dannyandreev/TheLittleRascal-Electrical/Prime Mover V1.6/Prime Mover V1.6 BOM/Prime Mover V1.6 BOM.ods

Id | Designator | Package | Quantity | Designation | Supplier and ref | Through
1 | JP1 | SolderJumper-2_P1.3mm_Open_RoundedPad1.0x1.5mm | 1 | Jumper_2_Bridged | N/A
2 | C7,C5 | C_0805_2012Metric | 2 | 4.7uF 16v | EMF212AB7475MGHT
3 | J7,J6,J1 | JST_PH_B6B-PH-K_1x06_P2.00mm_Vertical | 3 | Conn_01x06_Male | B6B-PH-K-S(LF)(SN) | TRUE
4 | C8,C6,C4 | CP_Elec_5x5.3 | 3 | 22uF 10v | 875105242005 | Double Check
5 | IC1 | SOP65P640X110-20N | 1 | NTS0308EPWJ | NTS0308EPWJ
6 | U2,U3 | SOIC-16_3.9x9.9mm_P1.27mm | 2 | MCP3008 | MCP3008
7 | J9,J10,J8 | JST_PH_B7B-PH-K_1x07_P2.00mm_Vertical | 3 | Conn_01x07_Male | B7B-PH-K-S(LF)(SN) | TRUE
8 | H1,H4,H3,H2 | MountingHole_3.2mm_M3_DIN965_Pad | 4 | MountingHole_Pad | N/A
9 | R8 | R_0805_2012Metric | 1 | 10k | RMCF0805JT10K0
10 | D2,D4,D3 | LED_0805_2012Metric | 3 | LED | XZMOK54W-1
11 | R6 | R_0805_2012Metric | 1 | 120k | RMCF0805JT120K
12 | L1 | INDPM7066X500N | 1 | 1uH | MWSA0624S-1R0MT
13 | J2 | JST_PH_B4B-PH-K_1x04_P2.00mm_Vertical | 1 | Conn_01x04_Male | B4B-PH-K-S(LF)(SN) | TRUE
14 | R7 | R_0805_2012Metric | 1 | 22k | ERJ-6GEYJ223V
15 | C10,C9 | C_0805_2012Metric | 2 | 1.0uF 16v | CC0805MKX7R7BB105
16 | J4 | JST_PH_B9B-PH-K_1x09_P2.00mm_Vertical | 1 | Conn_01x09_Male | B9B-PH-K-S(LF)(SN) | TRUE
17 | R10 | R_0805_2012Metric | 1 | 1k2 | RMCF0805JT1K20
18 | U1 | PCA9685 HW170 | 0 | PCA9685 | N/A
19 | R2,R1 | R_0805_2012Metric | 2 | 4k7 | RMCF0805JT4K70
20 | R4 | R_0805_2012Metric | 1 | 4.7k | RMCF0805JT4K70
21 | R9 | R_0805_2012Metric | 1 | 3k3 | RNCF0805DTE3K32
22 | J3,J5 | JST_PH_B3B-PH-K_1x03_P2.00mm_Vertical | 2 | Conn_01x03_Male | B3B-PH-K-S(LF)(SN) | TRUE
23 | IC2 | MAX20404AFOCVY | 1 | MAX20404AFOC_VY+ | MAX20405AFOD/VY+
24 | R5 | R_0805_2012Metric | 1 | 1.5k | RNCP0805FTD1K50
25 | C1 | C_0805_2012Metric | 1 | 0.1uF 16V | 0805YC104JAT4A
26 | D1 | D_SOD-323_HandSoldering | 1 | 3V6 | BZT52C3V6S-7-F
27 | C2 | C_0805_2012Metric | 1 | 0.1uF 16v | 0805YC104JAT4A
28 | C3 | C_0805_2012Metric | 1 | 2.2uF 10v | C0805X225K8RAC7800
29 | J11 | AMASS_XT60-M_1x02_P7.20mm_Vertical | 1 | Conn_01x02_Male | AMASS_XT60-M | TRUE
30 | R3 | PinSocket_2x20_P2.54mm_Vertical | 1 | Raspberry_Pi_2_3 | PPTC202LFBN-RC | TRUE
31 | J12 | MPU-6050-Module | 0 | Conn_01x08_Male | N/A
