dannyandreev/TheLittleRascal-Electrical/Prime Mover V1.6/Prime Mover.step.SLDASM

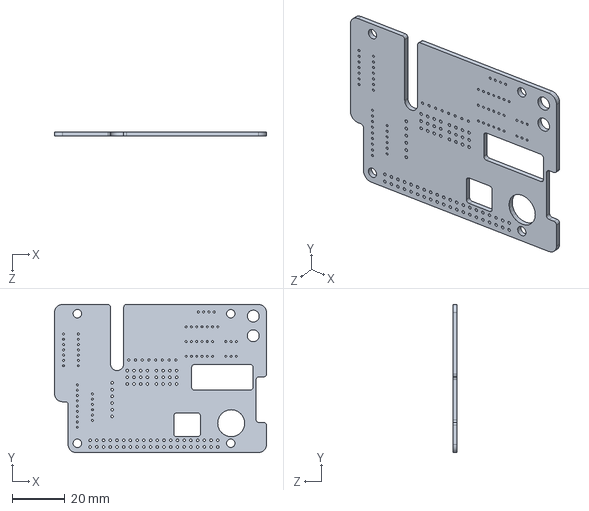
[picture p1: CAD file, 2022-08-15]
Prime Mover V1.6/Prime Mover.step.SLDASM
80.1 x 56.0 x 1.60 mm
