dannyandreev/TheLittleRascal-Electrical/(list of files, cad)

Other CAD files:
Prime Mover V1.6/Prime Mover.step
Prime Mover V1.5/Prime Mover.step
