dannyandreev/TheLittleRascal-Electrical/(threads)

Thread 1 (2021-09-09):

Schematic for RascalHat 1.0

ryanpleach, 2021-09-09:
**What is the feature and what does it do?**
We need to lay out everything that will connect to the Pi and how it will all connect. Based on this schematic, we can create the PCB layout.

**Describe the solution you'd like**
Create a library of sensors and PCBs in KiCad, figure out how they connect, and implement a schematic that describes the connections.

**Describe alternatives you've considered**
It is possible to not use a PCB, but doing this will minimize connectivity issues and the amount of wires. It will also be much easier to replace a given part. Danny was already familiar with KiCad.

Closed 2022-02-04.

Thread 12 (2022-02-04):

Mounting Holes Are wrong

dannyandreev, 2022-02-04:
mounting holes for raspi do not align, this may be caused by the 20x2 header not aligning properly

Thread 13 (2022-02-04):

Camera Cable Slit wrong

dannyandreev, 2022-02-04:
The slit for the camera is in the wrong position. To fix this position it over the camera plug
