dannyandreev/TheLittleRascal-Electrical/Prime Mover V1.6/Prime Mover.kicad_pcb

## KiCad design Prime Mover V1.6/Prime Mover.kicad_pcb (2022-11-23)

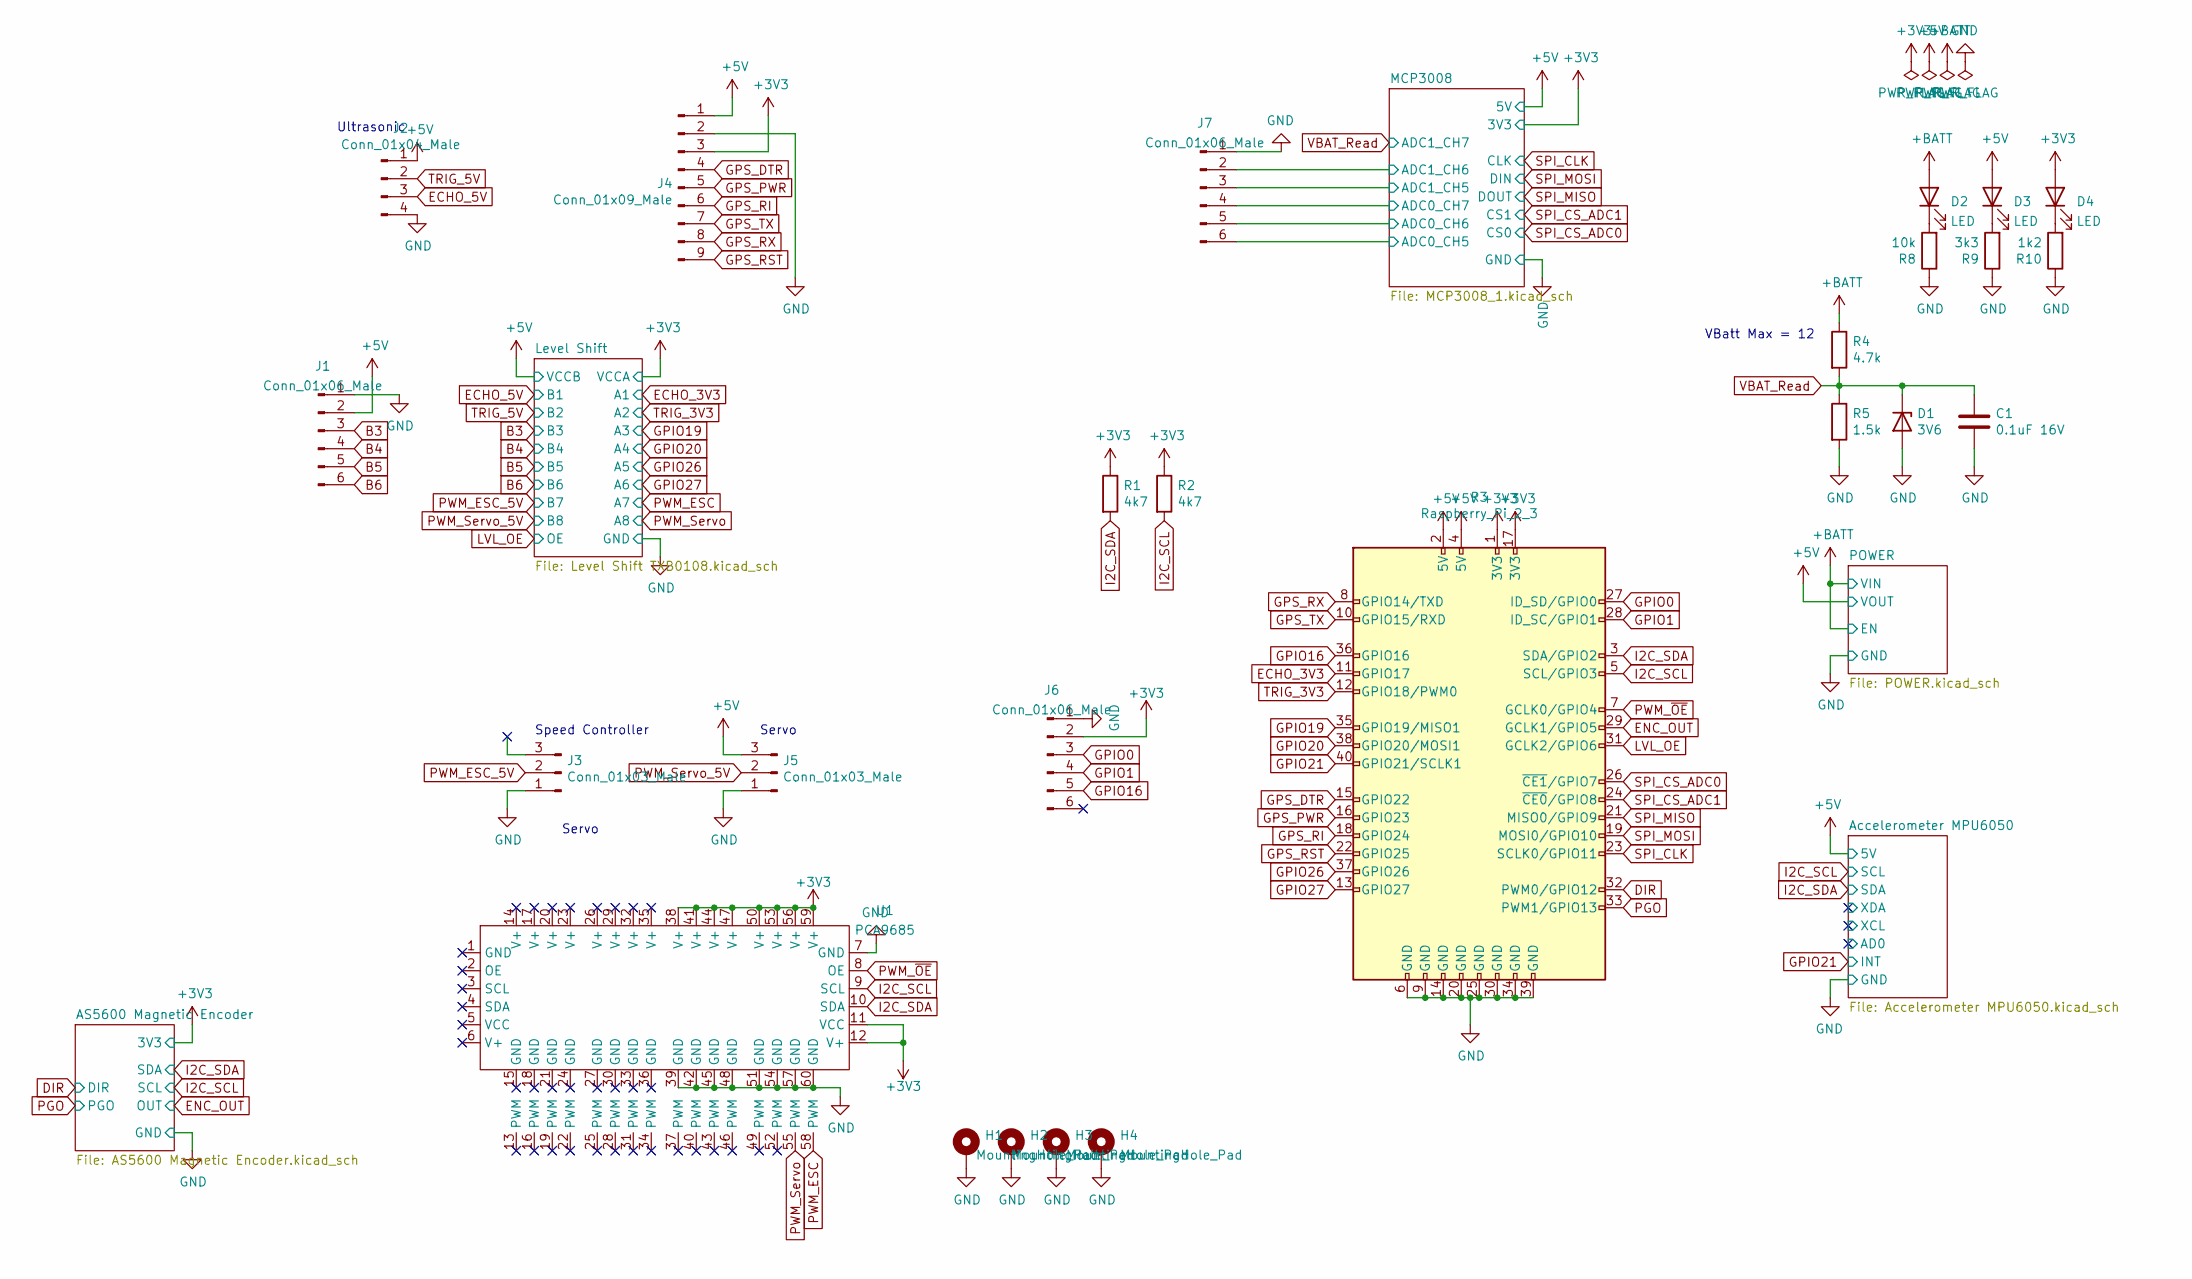
[picture p9: schematic Prime Mover.kicad_sch, RascalHat]

Parts:
C1: 0.1uF 16V; C_0805_2012Metric
D1: 3V6; D_SOD-323_HandSoldering
D2, D3, D4: LED; LED_0805_2012Metric
H1, H2, H3, H4: MountingHole_Pad; MountingHole_3.2mm_M3_DIN965_Pad
J1, J6, J7: Conn_01x06_Male; JST_PH_B6B-PH-K_1x06_P2.00mm_Vertical
J2: Conn_01x04_Male; JST_PH_B4B-PH-K_1x04_P2.00mm_Vertical
J3, J5: Conn_01x03_Male; JST_PH_B3B-PH-K_1x03_P2.00mm_Vertical
J4: Conn_01x09_Male; JST_PH_B9B-PH-K_1x09_P2.00mm_Vertical
R1, R2: 4k7; R_0805_2012Metric
R3: Raspberry_Pi_2_3; PinSocket_2x20_P2.54mm_Vertical
R4: 4.7k; R_0805_2012Metric
R5: 1.5k; R_0805_2012Metric
R8: 10k; R_0805_2012Metric
R9: 3k3; R_0805_2012Metric
R10: 1k2; R_0805_2012Metric
U1: PCA9685; PCA9685 HW170

Connections:
+3V3: D4.2 (A), J4.3, J6.2, R1.1, R2.1, R3.1 (3V3), R3.17 (3V3), U1.11 (VCC), U1.12 (V+), U1.38 (V+), U1.41 (V+), U1.44 (V+), U1.47 (V+), U1.50 (V+), U1.53 (V+), U1.56 (V+), U1.59 (V+); also elsewhere on the board
+5V: D3.2 (A), J1.2, J2.1, J4.1, J5.3, R3.2 (5V), R3.4 (5V); also elsewhere on the board
+BATT: D2.2 (A), R4.1; also elsewhere on the board
/MCP3008/ADC0_CH5: J7.6; also elsewhere on the board
/MCP3008/ADC0_CH6: J7.5; also elsewhere on the board
/MCP3008/ADC0_CH7: J7.4; also elsewhere on the board
/MCP3008/ADC1_CH5: J7.3; also elsewhere on the board
/MCP3008/ADC1_CH6: J7.2; also elsewhere on the board
B3: J1.3; also elsewhere on the board
B4: J1.4; also elsewhere on the board
B5: J1.5; also elsewhere on the board
B6: J1.6; also elsewhere on the board
DIR: R3.32 (PWM0/GPIO12); also elsewhere on the board
ECHO_3V3: R3.11 (GPIO17); also elsewhere on the board
ECHO_5V: J2.3; also elsewhere on the board
ENC_OUT: R3.29 (GCLK1/GPIO5); also elsewhere on the board
GND: C1.2, D1.2 (A), H1.1, H2.1, H3.1, H4.1, J1.1, J2.4, J3.1, J4.2, J5.1, J6.1, J7.1, R3.6 (GND), R3.9 (GND), R3.14 (GND), R3.20 (GND), R3.25 (GND), R3.30 (GND), R3.34 (GND), R3.39 (GND), R5.2, R8.1, R9.1, R10.1, U1.7 (GND), U1.39 (GND), U1.42 (GND), U1.45 (GND), U1.48 (GND), U1.51 (GND), U1.54 (GND), U1.57 (GND), U1.60 (GND); also elsewhere on the board
GPIO0: J6.3, R3.27 (ID_SD/GPIO0)
GPIO1: J6.4, R3.28 (ID_SC/GPIO1)
GPIO16: J6.5, R3.36 (GPIO16)
GPIO19: R3.35 (GPIO19/MISO1); also elsewhere on the board
GPIO20: R3.38 (GPIO20/MOSI1); also elsewhere on the board
GPIO21: R3.40 (GPIO21/SCLK1); also elsewhere on the board
GPIO26: R3.37 (GPIO26); also elsewhere on the board
GPIO27: R3.13 (GPIO27); also elsewhere on the board
GPS_DTR: J4.4, R3.15 (GPIO22)
GPS_PWR: J4.5, R3.16 (GPIO23)
GPS_RI: J4.6, R3.18 (GPIO24)
GPS_RST: J4.9, R3.22 (GPIO25)
GPS_RX: J4.8, R3.8 (GPIO14/TXD)
GPS_TX: J4.7, R3.10 (GPIO15/RXD)
I2C_SCL: R2.2, R3.5 (SCL/GPIO3), U1.9 (SCL); also elsewhere on the board
I2C_SDA: R1.2, R3.3 (SDA/GPIO2), U1.10 (SDA); also elsewhere on the board
LVL_OE: R3.31 (GCLK2/GPIO6); also elsewhere on the board
unnamed: D2.1 (K), R8.2
unnamed: D3.1 (K), R9.2
unnamed: D4.1 (K), R10.2
PGO: R3.33 (PWM1/GPIO13); also elsewhere on the board
PWM_ESC: U1.58 (PWM); also elsewhere on the board
PWM_ESC_5V: J3.2; also elsewhere on the board
PWM_Servo: U1.55 (PWM); also elsewhere on the board
PWM_Servo_5V: J5.2; also elsewhere on the board
PWM_~OE: R3.7 (GCLK0/GPIO4), U1.8 (OE)
SPI_CLK: R3.23 (SCLK0/GPIO11); also elsewhere on the board
SPI_CS_ADC0: R3.26 (~CE1/GPIO7); also elsewhere on the board
SPI_CS_ADC1: R3.24 (~CE0/GPIO8); also elsewhere on the board
SPI_MISO: R3.21 (MISO0/GPIO9); also elsewhere on the board
SPI_MOSI: R3.19 (MOSI0/GPIO10); also elsewhere on the board
TRIG_3V3: R3.12 (GPIO18/PWM0); also elsewhere on the board
TRIG_5V: J2.2; also elsewhere on the board
VBAT_Read: C1.1, D1.1 (K), R4.2, R5.1; also elsewhere on the board

Notes on the sheet:
Servo
VBatt Max = 12
Ultrasonic
Speed Controller

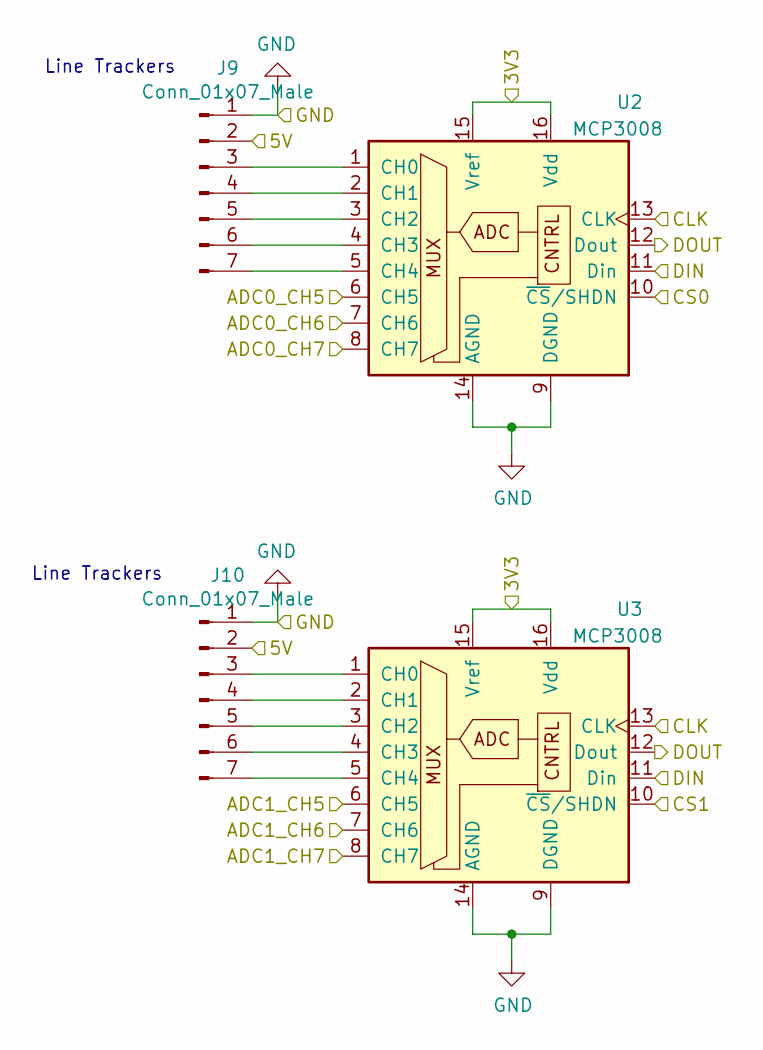
[picture p10: schematic MCP3008_1.kicad_sch]

Parts:
J9, J10: Conn_01x07_Male; JST_PH_B7B-PH-K_1x07_P2.00mm_Vertical
U2, U3: MCP3008; SOIC-16_3.9x9.9mm_P1.27mm

Connections:
+3V3: U2.15 (Vref), U2.16 (Vdd), U3.15 (Vref), U3.16 (Vdd); also elsewhere on the board
+5V: J9.2, J10.2; also elsewhere on the board
/MCP3008/ADC0_CH5: U2.6 (CH5); also elsewhere on the board
/MCP3008/ADC0_CH6: U2.7 (CH6); also elsewhere on the board
/MCP3008/ADC0_CH7: U2.8 (CH7); also elsewhere on the board
/MCP3008/ADC1_CH5: U3.6 (CH5); also elsewhere on the board
/MCP3008/ADC1_CH6: U3.7 (CH6); also elsewhere on the board
GND: J9.1, J10.1, U2.9 (DGND), U2.14 (AGND), U3.9 (DGND), U3.14 (AGND); also elsewhere on the board
unnamed: J9.3, U2.1 (CH0)
unnamed: J9.4, U2.2 (CH1)
unnamed: J9.5, U2.3 (CH2)
unnamed: J9.6, U2.4 (CH3)
unnamed: J9.7, U2.5 (CH4)
unnamed: J10.3, U3.1 (CH0)
unnamed: J10.4, U3.2 (CH1)
unnamed: J10.5, U3.3 (CH2)
unnamed: J10.6, U3.4 (CH3)
unnamed: J10.7, U3.5 (CH4)
SPI_CLK: U2.13 (CLK), U3.13 (CLK); also elsewhere on the board
SPI_CS_ADC0: U2.10 (~CS/SHDN); also elsewhere on the board
SPI_CS_ADC1: U3.10 (~CS/SHDN); also elsewhere on the board
SPI_MISO: U2.12 (Dout), U3.12 (Dout); also elsewhere on the board
SPI_MOSI: U2.11 (Din), U3.11 (Din); also elsewhere on the board
VBAT_Read: U3.8 (CH7); also elsewhere on the board

Notes on the sheet:
Line Trackers

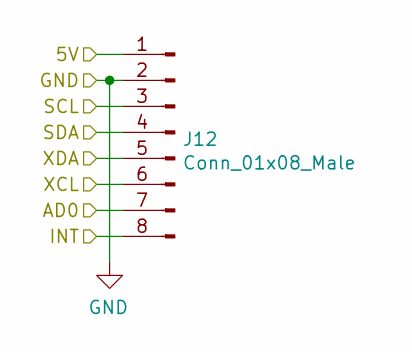
[picture p11: schematic Accelerometer MPU6050.kicad_sch]

Parts:
J12: Conn_01x08_Male; MPU-6050-Module

Connections:
+5V: J12.1; also elsewhere on the board
/Accelerometer MPU6050/AD0: J12.7
/Accelerometer MPU6050/XCL: J12.6
/Accelerometer MPU6050/XDA: J12.5
GND: J12.2; also elsewhere on the board
GPIO21: J12.8; also elsewhere on the board
I2C_SCL: J12.3; also elsewhere on the board
I2C_SDA: J12.4; also elsewhere on the board

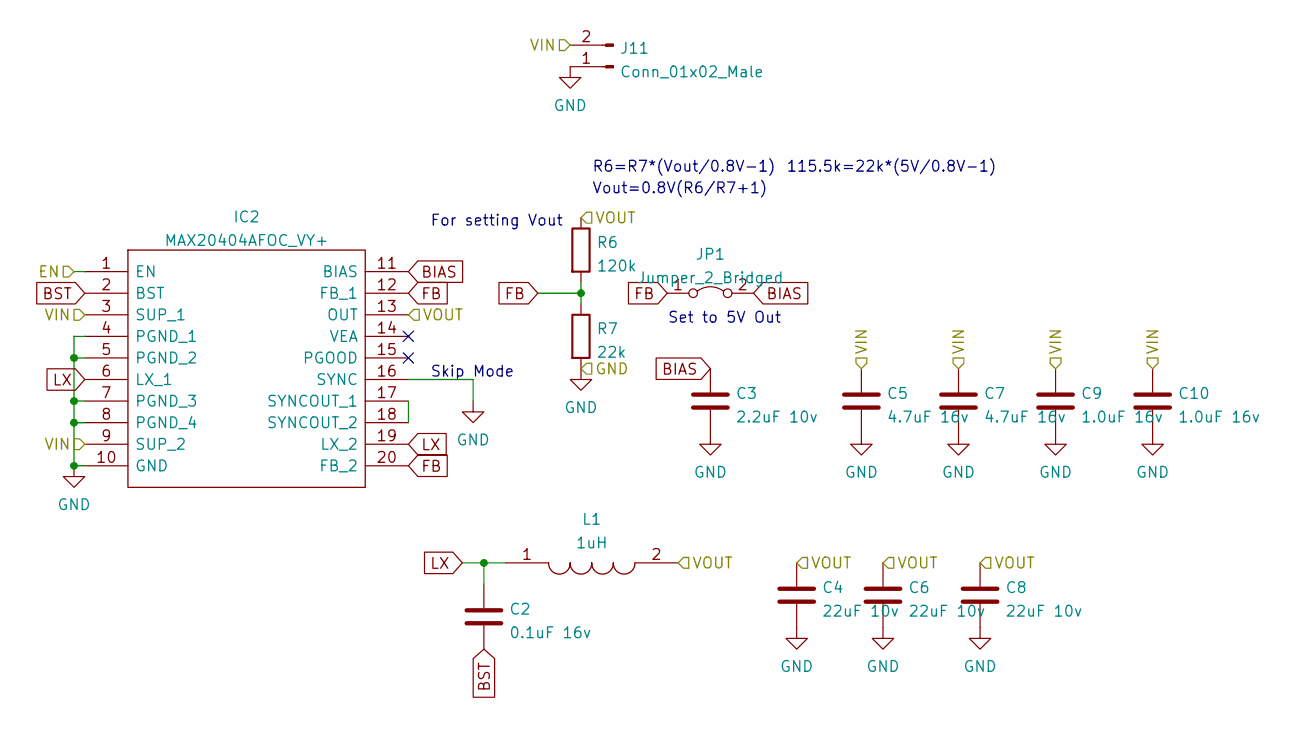
[picture p12: schematic POWER.kicad_sch]

Parts:
C2: 0.1uF 16v; C_0805_2012Metric
C3: 2.2uF 10v; C_0805_2012Metric
C4, C6, C8: 22uF 10v; CP_Elec_5x5.3
C5, C7: 4.7uF 16v; C_0805_2012Metric
C9, C10: 1.0uF 16v; C_0805_2012Metric
IC2: MAX20404AFOC_VY+; MAX20404AFOCVY; Manufacturer_Part_Number MAX20404AFOC/VY+
J11: Conn_01x02_Male; AMASS_XT60-M_1x02_P7.20mm_Vertical
JP1: Jumper_2_Bridged; SolderJumper-2_P1.3mm_Open_RoundedPad1.0x1.5mm
L1: 1uH; INDPM7066X500N; Manufacturer_Part_Number MWSA0605S-150MT
R6: 120k; R_0805_2012Metric
R7: 22k; R_0805_2012Metric

Connections:
+5V: C4.1, C6.1, C8.1, IC2.13 (OUT), L1.2, R6.1; also elsewhere on the board
+BATT: C5.1, C7.1, C9.1, C10.1, IC2.1 (EN), IC2.3 (SUP_1), IC2.9 (SUP_2), J11.2; also elsewhere on the board
BIAS: C3.1, IC2.11 (BIAS), JP1.2 (B)
BST: C2.2, IC2.2 (BST)
FB: IC2.12 (FB_1), IC2.20 (FB_2), JP1.1 (A), R6.2, R7.1
GND: C3.2, C4.2, C5.2, C6.2, C7.2, C8.2, C9.2, C10.2, IC2.4 (PGND_1), IC2.5 (PGND_2), IC2.7 (PGND_3), IC2.8 (PGND_4), IC2.10 (GND), IC2.16 (SYNC), J11.1, R7.2; also elsewhere on the board
LX: C2.1, IC2.6 (LX_1), IC2.19 (LX_2), L1.1
unnamed: IC2.17 (SYNCOUT_1), IC2.18 (SYNCOUT_2)

Notes on the sheet:
Vout=0.8V(R6/R7+1)
For setting Vout
Skip Mode
Set to 5V Out
R6=R7*(Vout/0.8V-1)
115.5k=22k*(5V/0.8V-1)

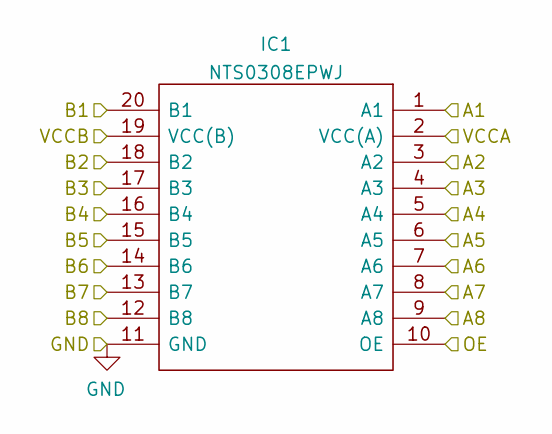
[picture p13: schematic Level Shift TXB0108.kicad_sch]

Parts:
IC1: NTS0308EPWJ; SOP65P640X110-20N; Manufacturer_Part_Number NTS0308EPWJ; Mouser Part Number 771-NTS0308EPWJ

Connections:
+3V3: IC1.2 (VCC(A)); also elsewhere on the board
+5V: IC1.19 (VCC(B)); also elsewhere on the board
B3: IC1.17 (B3); also elsewhere on the board
B4: IC1.16 (B4); also elsewhere on the board
B5: IC1.15 (B5); also elsewhere on the board
B6: IC1.14 (B6); also elsewhere on the board
ECHO_3V3: IC1.1 (A1); also elsewhere on the board
ECHO_5V: IC1.20 (B1); also elsewhere on the board
GND: IC1.11 (GND); also elsewhere on the board
GPIO19: IC1.4 (A3); also elsewhere on the board
GPIO20: IC1.5 (A4); also elsewhere on the board
GPIO26: IC1.6 (A5); also elsewhere on the board
GPIO27: IC1.7 (A6); also elsewhere on the board
LVL_OE: IC1.10 (OE); also elsewhere on the board
PWM_ESC: IC1.8 (A7); also elsewhere on the board
PWM_ESC_5V: IC1.13 (B7); also elsewhere on the board
PWM_Servo: IC1.9 (A8); also elsewhere on the board
PWM_Servo_5V: IC1.12 (B8); also elsewhere on the board
TRIG_3V3: IC1.3 (A2); also elsewhere on the board
TRIG_5V: IC1.18 (B2); also elsewhere on the board

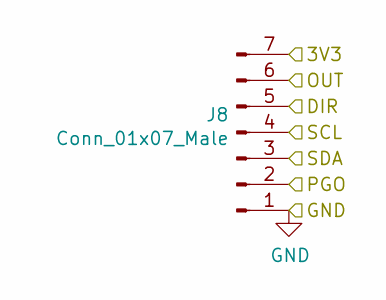
[picture p14: schematic AS5600 Magnetic Encoder.kicad_sch]

Parts:
J8: Conn_01x07_Male; JST_PH_B7B-PH-K_1x07_P2.00mm_Vertical

Connections:
+3V3: J8.7; also elsewhere on the board
DIR: J8.5; also elsewhere on the board
ENC_OUT: J8.6; also elsewhere on the board
GND: J8.1; also elsewhere on the board
I2C_SCL: J8.4; also elsewhere on the board
I2C_SDA: J8.3; also elsewhere on the board
PGO: J8.2; also elsewhere on the board

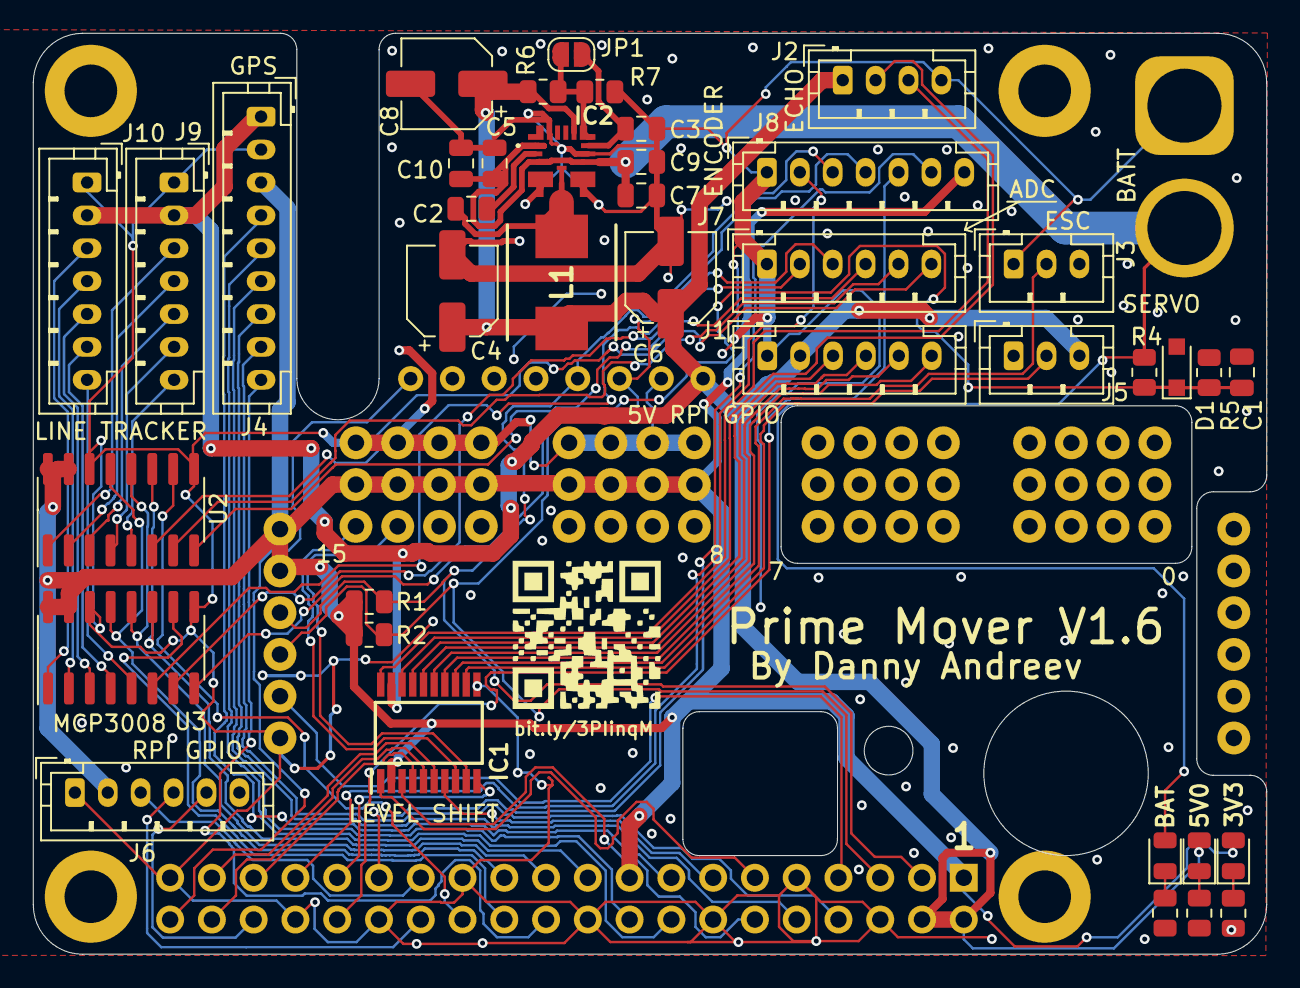
[picture p15: board Prime Mover.kicad_pcb from above]

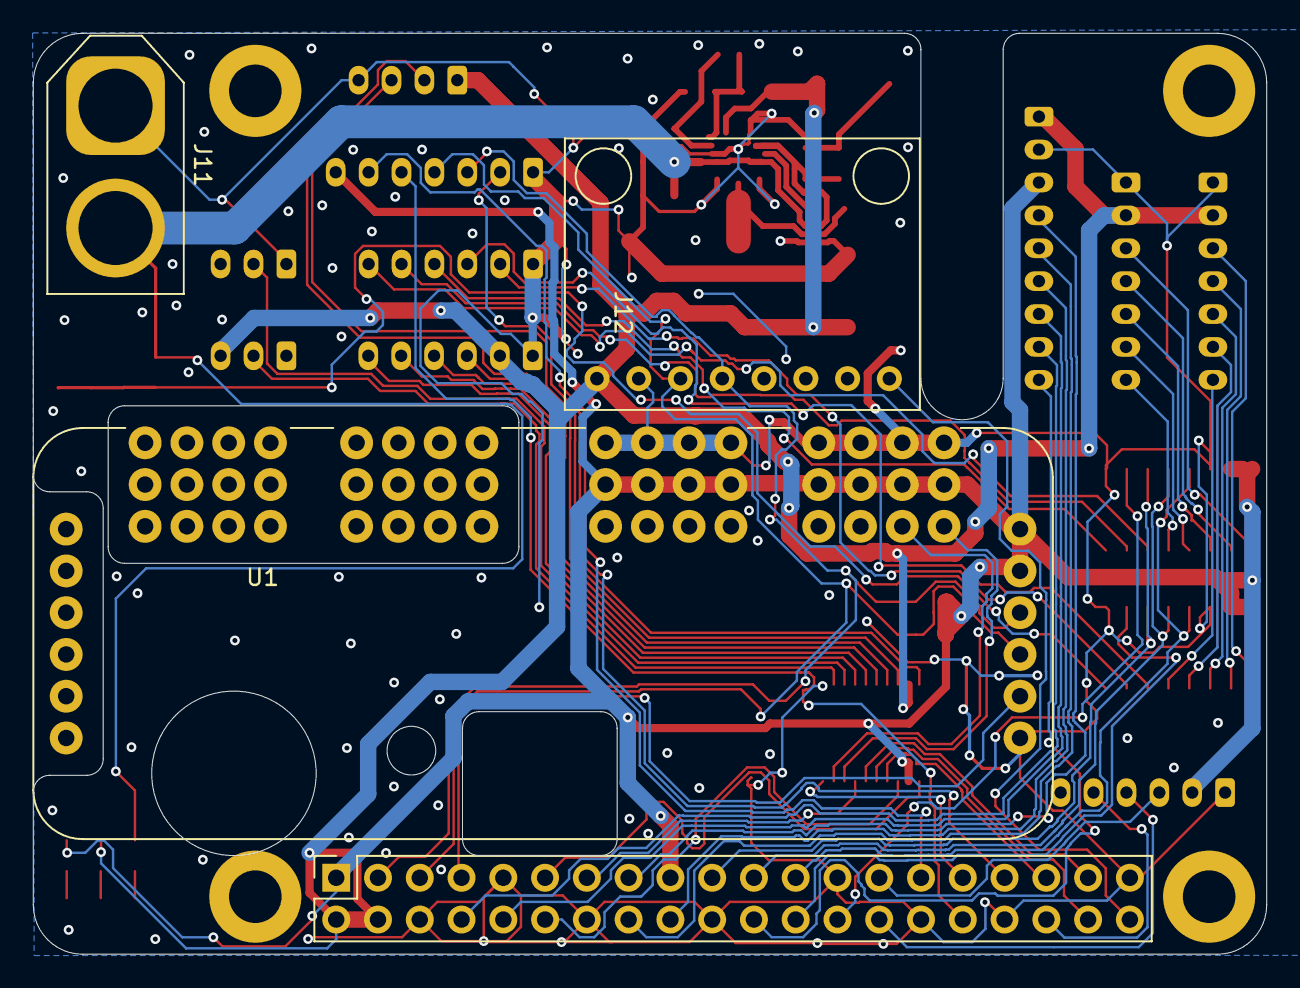
[picture p16: board Prime Mover.kicad_pcb from below]

Board: 2 copper layers, 75.0 x 56.0 mm, 47 parts (3 on the bottom side), 66 nets.
