dannyandreev/TheLittleRascal-Electrical/PiCar Hat V1.0/PiCar Hat.kicad_pcb

## KiCad design PiCar Hat V1.0/PiCar Hat.kicad_pcb (2022-02-22)

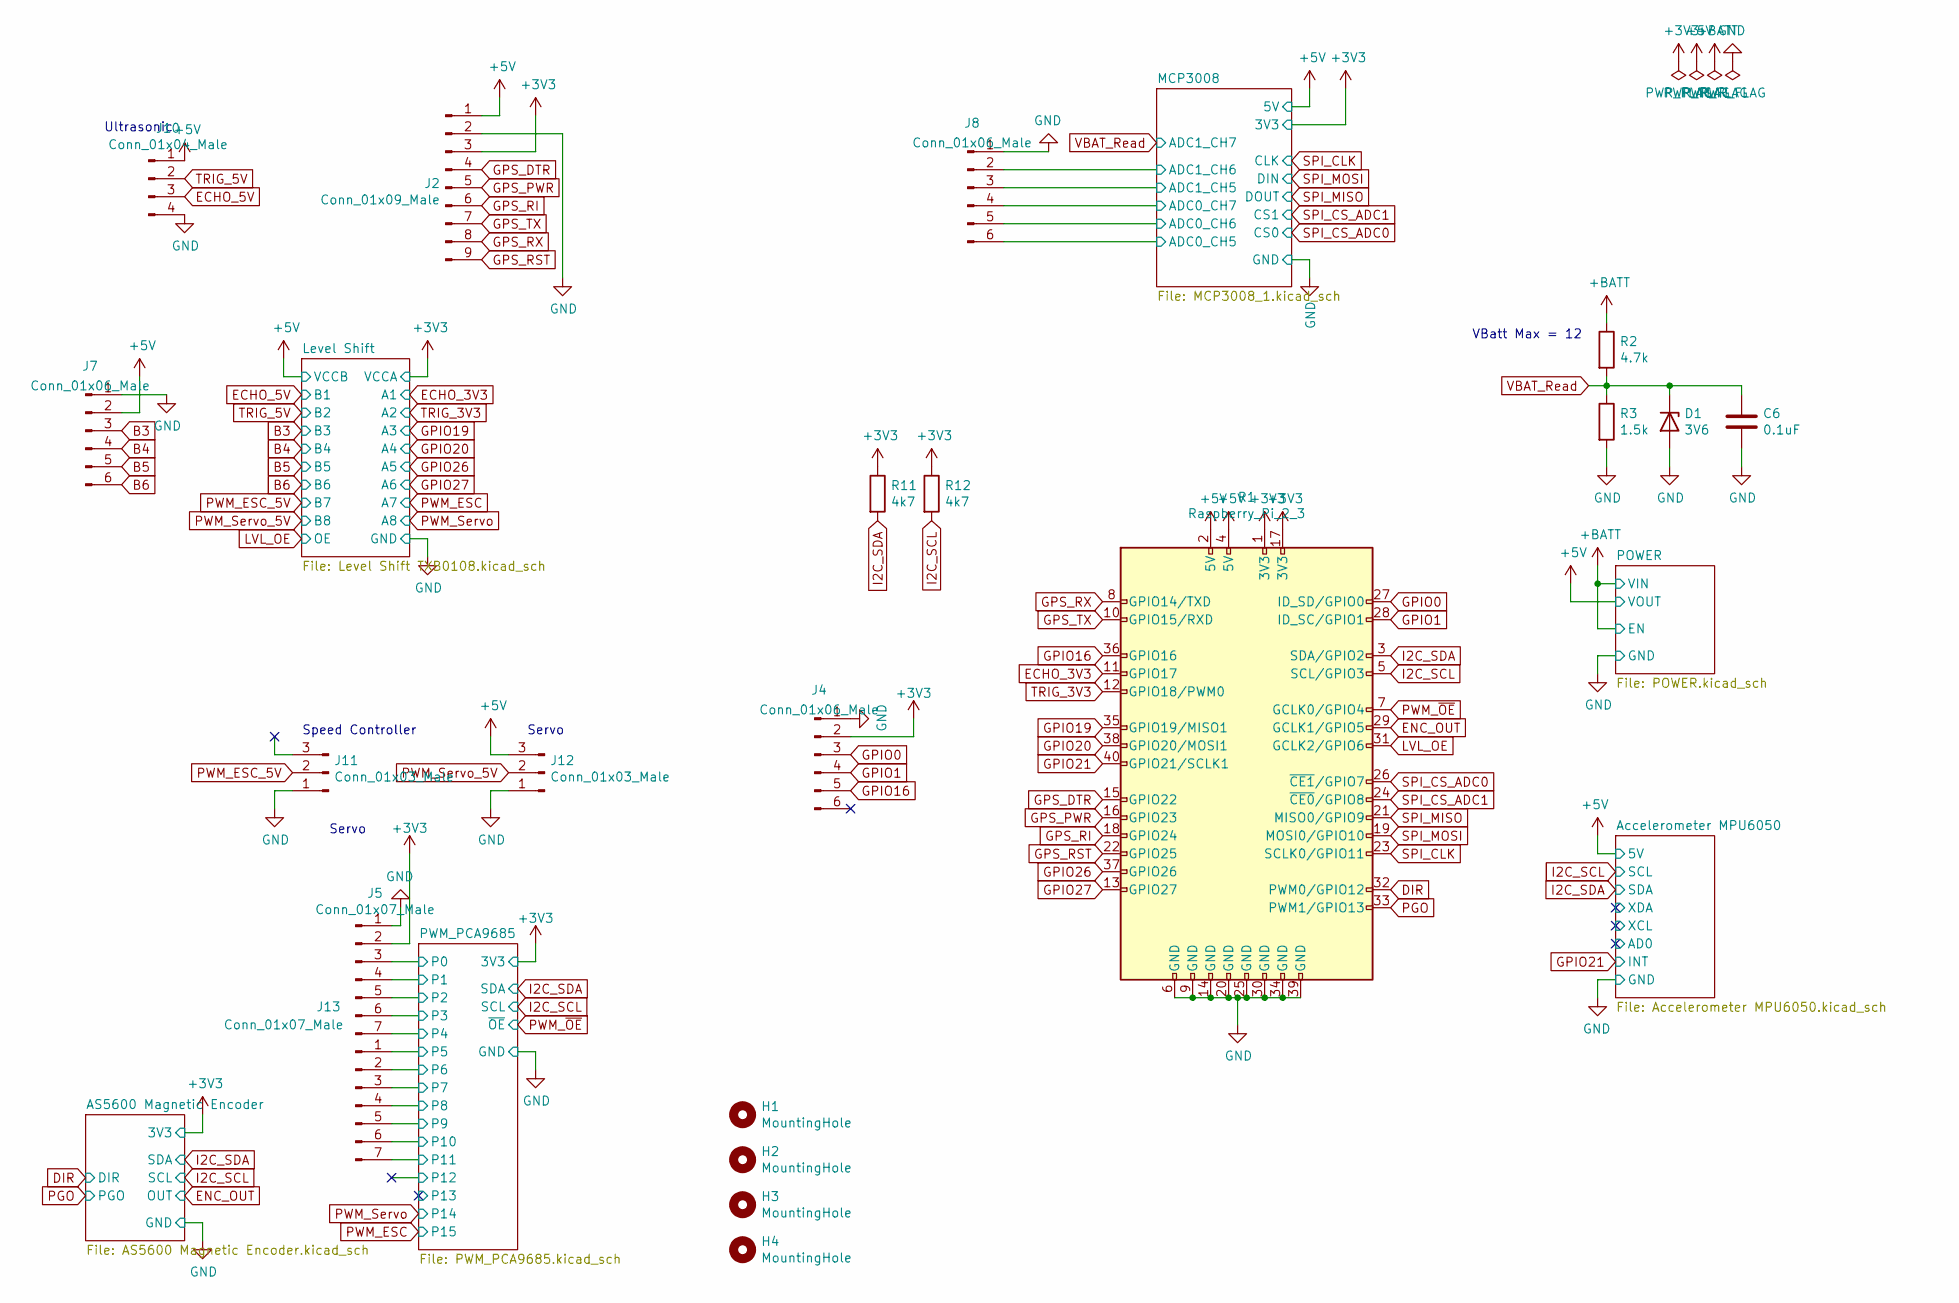
[picture p17: schematic PiCar Hat.kicad_sch, RascalHat]

Parts:
C6: 0.1uF; C_0805_2012Metric
D1: 3V6; D_SOD-323_HandSoldering
H1, H2, H3, H4: MountingHole; MountingHole_3.2mm_M3
J2: Conn_01x09_Male; JST_PH_B9B-PH-K_1x09_P2.00mm_Vertical
J4, J7, J8: Conn_01x06_Male; JST_PH_B6B-PH-K_1x06_P2.00mm_Vertical
J5, J13: Conn_01x07_Male; JST_PH_B7B-PH-K_1x07_P2.00mm_Vertical
J10: Conn_01x04_Male; JST_PH_B4B-PH-K_1x04_P2.00mm_Vertical
J11, J12: Conn_01x03_Male; JST_PH_B3B-PH-K_1x03_P2.00mm_Vertical
R1: Raspberry_Pi_2_3; PinSocket_2x20_P2.54mm_Vertical
R2: 4.7k; R_0805_2012Metric
R3: 1.5k; R_0805_2012Metric
R11, R12: 4k7; R_0805_2012Metric

Connections:
+3V3: J2.3, J4.2, J5.2, R1.1 (3V3), R1.17 (3V3), R11.1, R12.1; also elsewhere on the board
+5V: J2.1, J7.2, J10.1, J12.3, R1.2 (5V), R1.4 (5V); also elsewhere on the board
+BATT: R2.1; also elsewhere on the board
/MCP3008/ADC0_CH5: J8.6; also elsewhere on the board
/MCP3008/ADC0_CH6: J8.5; also elsewhere on the board
/MCP3008/ADC0_CH7: J8.4; also elsewhere on the board
/MCP3008/ADC1_CH5: J8.3; also elsewhere on the board
/MCP3008/ADC1_CH6: J8.2; also elsewhere on the board
/PWM_PCA9685/P0: J5.3; also elsewhere on the board
/PWM_PCA9685/P1: J5.4; also elsewhere on the board
/PWM_PCA9685/P2: J5.5; also elsewhere on the board
/PWM_PCA9685/P3: J5.6; also elsewhere on the board
/PWM_PCA9685/P4: J5.7; also elsewhere on the board
/PWM_PCA9685/P5: J13.1; also elsewhere on the board
/PWM_PCA9685/P6: J13.2; also elsewhere on the board
/PWM_PCA9685/P7: J13.3; also elsewhere on the board
/PWM_PCA9685/P8: J13.4; also elsewhere on the board
/PWM_PCA9685/P9: J13.5; also elsewhere on the board
/PWM_PCA9685/P10: J13.6; also elsewhere on the board
/PWM_PCA9685/P11: J13.7; also elsewhere on the board
B3: J7.3; also elsewhere on the board
B4: J7.4; also elsewhere on the board
B5: J7.5; also elsewhere on the board
B6: J7.6; also elsewhere on the board
DIR: R1.32 (PWM0/GPIO12); also elsewhere on the board
ECHO_3V3: R1.11 (GPIO17); also elsewhere on the board
ECHO_5V: J10.3; also elsewhere on the board
ENC_OUT: R1.29 (GCLK1/GPIO5); also elsewhere on the board
GND: C6.2, D1.2 (A), J2.2, J4.1, J5.1, J7.1, J8.1, J10.4, J11.1, J12.1, R1.6 (GND), R1.9 (GND), R1.14 (GND), R1.20 (GND), R1.25 (GND), R1.30 (GND), R1.34 (GND), R1.39 (GND), R3.2; also elsewhere on the board
GPIO0: J4.3, R1.27 (ID_SD/GPIO0)
GPIO1: J4.4, R1.28 (ID_SC/GPIO1)
GPIO16: J4.5, R1.36 (GPIO16)
GPIO19: R1.35 (GPIO19/MISO1); also elsewhere on the board
GPIO20: R1.38 (GPIO20/MOSI1); also elsewhere on the board
GPIO21: R1.40 (GPIO21/SCLK1); also elsewhere on the board
GPIO26: R1.37 (GPIO26); also elsewhere on the board
GPIO27: R1.13 (GPIO27); also elsewhere on the board
GPS_DTR: J2.4, R1.15 (GPIO22)
GPS_PWR: J2.5, R1.16 (GPIO23)
GPS_RI: J2.6, R1.18 (GPIO24)
GPS_RST: J2.9, R1.22 (GPIO25)
GPS_RX: J2.8, R1.8 (GPIO14/TXD)
GPS_TX: J2.7, R1.10 (GPIO15/RXD)
I2C_SCL: R1.5 (SCL/GPIO3), R12.2; also elsewhere on the board
I2C_SDA: R1.3 (SDA/GPIO2), R11.2; also elsewhere on the board
LVL_OE: R1.31 (GCLK2/GPIO6); also elsewhere on the board
PGO: R1.33 (PWM1/GPIO13); also elsewhere on the board
PWM_ESC_5V: J11.2; also elsewhere on the board
PWM_Servo_5V: J12.2; also elsewhere on the board
PWM_~OE: R1.7 (GCLK0/GPIO4); also elsewhere on the board
SPI_CLK: R1.23 (SCLK0/GPIO11); also elsewhere on the board
SPI_CS_ADC0: R1.26 (~CE1/GPIO7); also elsewhere on the board
SPI_CS_ADC1: R1.24 (~CE0/GPIO8); also elsewhere on the board
SPI_MISO: R1.21 (MISO0/GPIO9); also elsewhere on the board
SPI_MOSI: R1.19 (MOSI0/GPIO10); also elsewhere on the board
TRIG_3V3: R1.12 (GPIO18/PWM0); also elsewhere on the board
TRIG_5V: J10.2; also elsewhere on the board
VBAT_Read: C6.1, D1.1 (K), R2.2, R3.1; also elsewhere on the board

Notes on the sheet:
Servo
VBatt Max = 12
Ultrasonic
Speed Controller

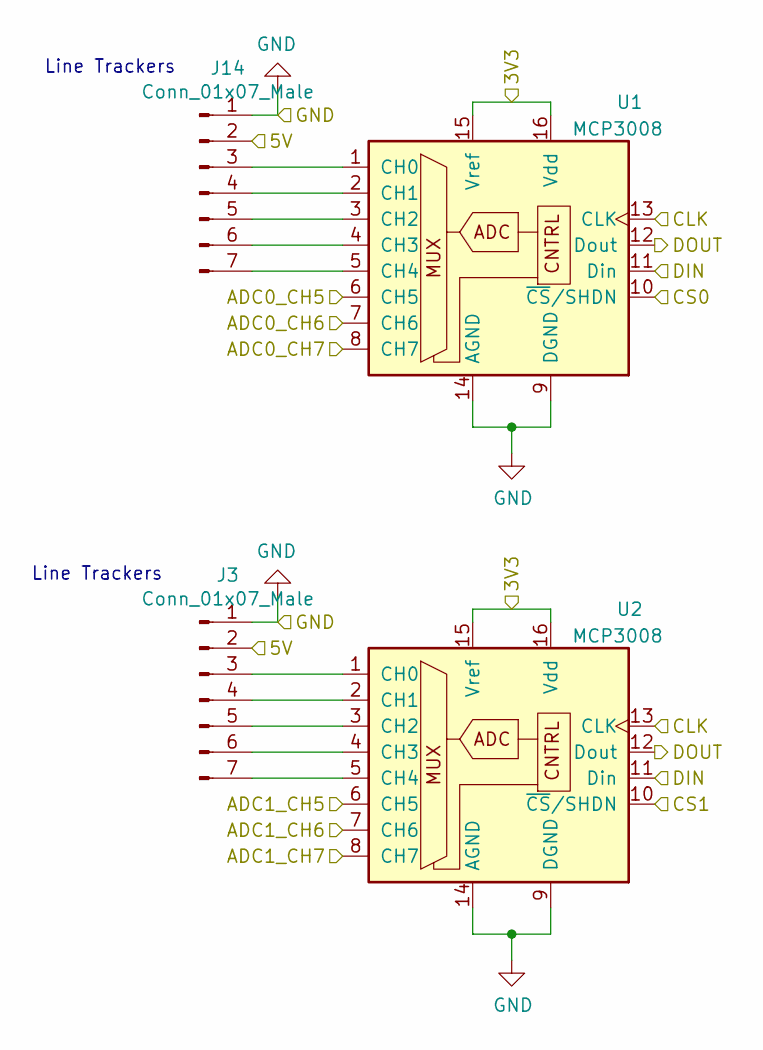
[picture p18: schematic MCP3008_1.kicad_sch]

Parts:
J3, J14: Conn_01x07_Male; JST_PH_B7B-PH-K_1x07_P2.00mm_Vertical
U1, U2: MCP3008; SOIC-16_3.9x9.9mm_P1.27mm

Connections:
+3V3: U1.15 (Vref), U1.16 (Vdd), U2.15 (Vref), U2.16 (Vdd); also elsewhere on the board
+5V: J3.2, J14.2; also elsewhere on the board
/MCP3008/ADC0_CH5: U1.6 (CH5); also elsewhere on the board
/MCP3008/ADC0_CH6: U1.7 (CH6); also elsewhere on the board
/MCP3008/ADC0_CH7: U1.8 (CH7); also elsewhere on the board
/MCP3008/ADC1_CH5: U2.6 (CH5); also elsewhere on the board
/MCP3008/ADC1_CH6: U2.7 (CH6); also elsewhere on the board
GND: J3.1, J14.1, U1.9 (DGND), U1.14 (AGND), U2.9 (DGND), U2.14 (AGND); also elsewhere on the board
unnamed: J3.3, U2.1 (CH0)
unnamed: J3.4, U2.2 (CH1)
unnamed: J3.5, U2.3 (CH2)
unnamed: J3.6, U2.4 (CH3)
unnamed: J3.7, U2.5 (CH4)
unnamed: J14.3, U1.1 (CH0)
unnamed: J14.4, U1.2 (CH1)
unnamed: J14.5, U1.3 (CH2)
unnamed: J14.6, U1.4 (CH3)
unnamed: J14.7, U1.5 (CH4)
SPI_CLK: U1.13 (CLK), U2.13 (CLK); also elsewhere on the board
SPI_CS_ADC0: U1.10 (~CS/SHDN); also elsewhere on the board
SPI_CS_ADC1: U2.10 (~CS/SHDN); also elsewhere on the board
SPI_MISO: U1.12 (Dout), U2.12 (Dout); also elsewhere on the board
SPI_MOSI: U1.11 (Din), U2.11 (Din); also elsewhere on the board
VBAT_Read: U2.8 (CH7); also elsewhere on the board

Notes on the sheet:
Line Trackers

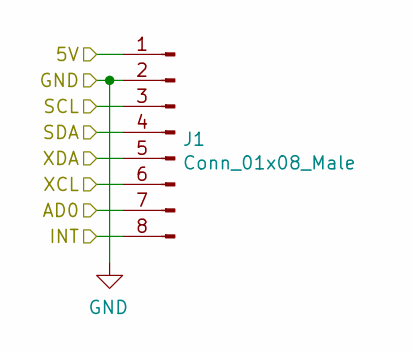
[picture p19: schematic Accelerometer MPU6050.kicad_sch]

Parts:
J1: Conn_01x08_Male; MPU-6050-Module

Connections:
+5V: J1.1; also elsewhere on the board
/Accelerometer MPU6050/AD0: J1.7
/Accelerometer MPU6050/XCL: J1.6
/Accelerometer MPU6050/XDA: J1.5
GND: J1.2; also elsewhere on the board
GPIO21: J1.8; also elsewhere on the board
I2C_SCL: J1.3; also elsewhere on the board
I2C_SDA: J1.4; also elsewhere on the board

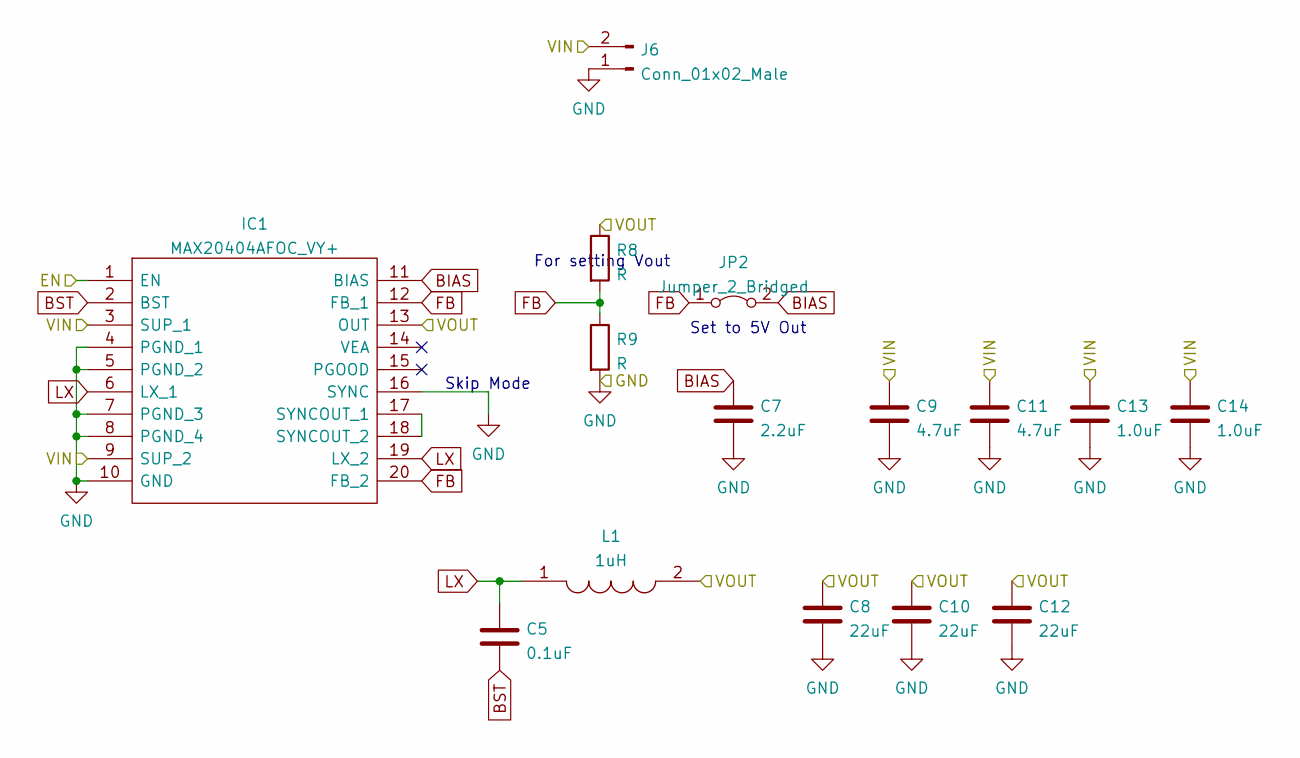
[picture p20: schematic POWER.kicad_sch]

Parts:
C5: 0.1uF; C_0805_2012Metric
C7: 2.2uF; C_0805_2012Metric
C8, C10, C12: 22uF; CP_Elec_5x5.3
C9, C11: 4.7uF; C_0805_2012Metric
C13, C14: 1.0uF; C_0805_2012Metric
IC1: MAX20404AFOC_VY+; MAX20404AFOCVY; Manufacturer_Part_Number MAX20404AFOC/VY+
J6: Conn_01x02_Male; AMASS_XT60-M_1x02_P7.20mm_Vertical
JP2: Jumper_2_Bridged; PinHeader_1x02_P2.54mm_Vertical
L1: 1uH; INDPM7066X500N; Manufacturer_Part_Number MWSA0605S-150MT
R8, R9: R; R_0805_2012Metric

Connections:
+5V: C8.1, C10.1, C12.1, IC1.13 (OUT), L1.2, R8.1; also elsewhere on the board
+BATT: C9.1, C11.1, C13.1, C14.1, IC1.1 (EN), IC1.3 (SUP_1), IC1.9 (SUP_2), J6.2; also elsewhere on the board
BIAS: C7.1, IC1.11 (BIAS), JP2.2 (B)
BST: C5.2, IC1.2 (BST)
FB: IC1.12 (FB_1), IC1.20 (FB_2), JP2.1 (A), R8.2, R9.1
GND: C7.2, C8.2, C9.2, C10.2, C11.2, C12.2, C13.2, C14.2, IC1.4 (PGND_1), IC1.5 (PGND_2), IC1.7 (PGND_3), IC1.8 (PGND_4), IC1.10 (GND), IC1.16 (SYNC), J6.1, R9.2; also elsewhere on the board
LX: C5.1, IC1.6 (LX_1), IC1.19 (LX_2), L1.1
unnamed: IC1.17 (SYNCOUT_1), IC1.18 (SYNCOUT_2)

Notes on the sheet:
For setting Vout
Skip Mode
Set to 5V Out

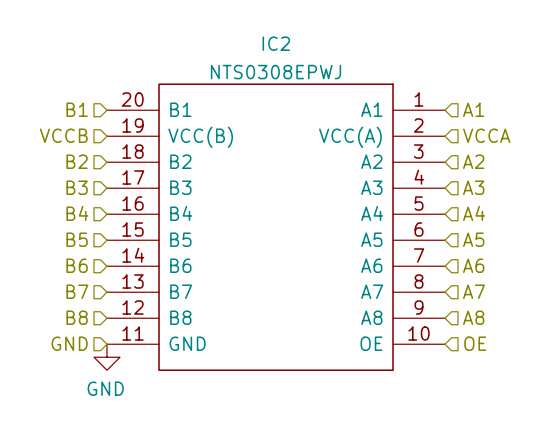
[picture p21: schematic Level Shift TXB0108.kicad_sch]

Parts:
IC2: NTS0308EPWJ; SOP65P640X110-20N; Manufacturer_Part_Number NTS0308EPWJ; Mouser Part Number 771-NTS0308EPWJ

Connections:
+3V3: IC2.2 (VCC(A)); also elsewhere on the board
+5V: IC2.19 (VCC(B)); also elsewhere on the board
B3: IC2.17 (B3); also elsewhere on the board
B4: IC2.16 (B4); also elsewhere on the board
B5: IC2.15 (B5); also elsewhere on the board
B6: IC2.14 (B6); also elsewhere on the board
ECHO_3V3: IC2.1 (A1); also elsewhere on the board
ECHO_5V: IC2.20 (B1); also elsewhere on the board
GND: IC2.11 (GND); also elsewhere on the board
GPIO19: IC2.4 (A3); also elsewhere on the board
GPIO20: IC2.5 (A4); also elsewhere on the board
GPIO26: IC2.6 (A5); also elsewhere on the board
GPIO27: IC2.7 (A6); also elsewhere on the board
LVL_OE: IC2.10 (OE); also elsewhere on the board
PWM_ESC: IC2.8 (A7); also elsewhere on the board
PWM_ESC_5V: IC2.13 (B7); also elsewhere on the board
PWM_Servo: IC2.9 (A8); also elsewhere on the board
PWM_Servo_5V: IC2.12 (B8); also elsewhere on the board
TRIG_3V3: IC2.3 (A2); also elsewhere on the board
TRIG_5V: IC2.18 (B2); also elsewhere on the board
