dannyandreev/TheLittleRascal-Electrical/PiCar Hat V1.0/PiCar Hat.kicad_pcb

## KiCad design PiCar Hat V1.0/PiCar Hat.kicad_pcb (continued)

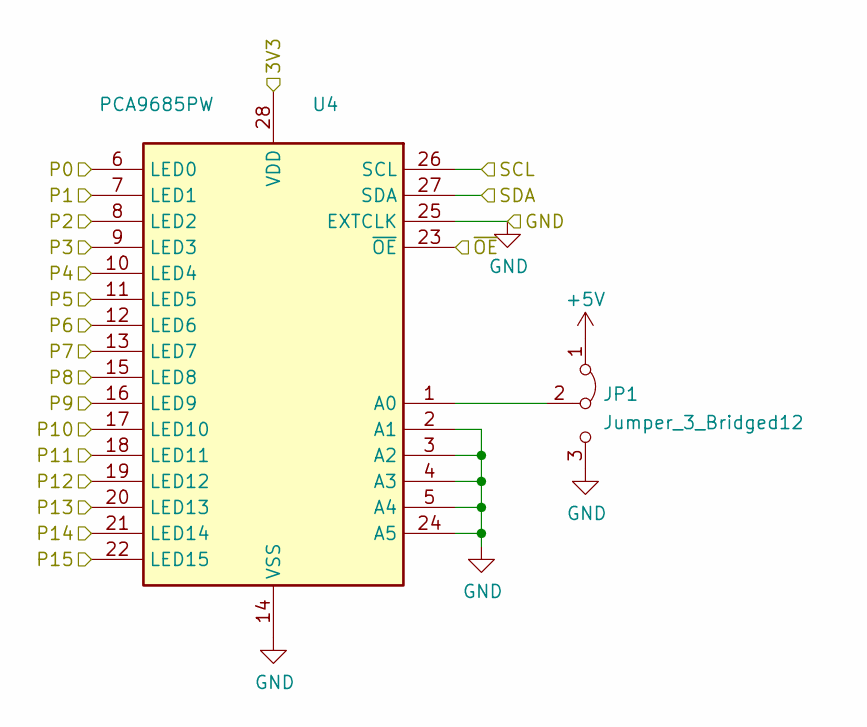
[picture p22: schematic PWM_PCA9685.kicad_sch]

Parts:
JP1: Jumper_3_Bridged12; PinHeader_1x03_P2.54mm_Vertical
U4: PCA9685PW; TSSOP-28_4.4x9.7mm_P0.65mm

Connections:
+3V3: U4.28 (VDD); also elsewhere on the board
+5V: JP1.1 (A); also elsewhere on the board
/PWM_PCA9685/P0: U4.6 (LED0); also elsewhere on the board
/PWM_PCA9685/P1: U4.7 (LED1); also elsewhere on the board
/PWM_PCA9685/P2: U4.8 (LED2); also elsewhere on the board
/PWM_PCA9685/P3: U4.9 (LED3); also elsewhere on the board
/PWM_PCA9685/P4: U4.10 (LED4); also elsewhere on the board
/PWM_PCA9685/P5: U4.11 (LED5); also elsewhere on the board
/PWM_PCA9685/P6: U4.12 (LED6); also elsewhere on the board
/PWM_PCA9685/P7: U4.13 (LED7); also elsewhere on the board
/PWM_PCA9685/P8: U4.15 (LED8); also elsewhere on the board
/PWM_PCA9685/P9: U4.16 (LED9); also elsewhere on the board
/PWM_PCA9685/P10: U4.17 (LED10); also elsewhere on the board
/PWM_PCA9685/P11: U4.18 (LED11); also elsewhere on the board
/PWM_PCA9685/P12: U4.19 (LED12)
/PWM_PCA9685/P13: U4.20 (LED13)
GND: JP1.3 (B), U4.2 (A1), U4.3 (A2), U4.4 (A3), U4.5 (A4), U4.14 (VSS), U4.24 (A5), U4.25 (EXTCLK); also elsewhere on the board
I2C_SCL: U4.26 (SCL); also elsewhere on the board
I2C_SDA: U4.27 (SDA); also elsewhere on the board
unnamed: JP1.2 (C), U4.1 (A0)
PWM_ESC: U4.22 (LED15); also elsewhere on the board
PWM_Servo: U4.21 (LED14); also elsewhere on the board
PWM_~OE: U4.23 (~OE); also elsewhere on the board

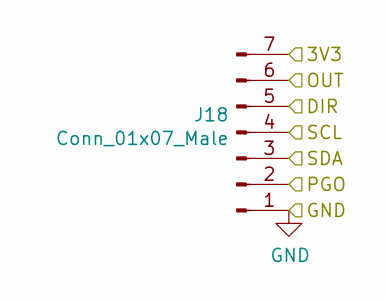
[picture p23: schematic AS5600 Magnetic Encoder.kicad_sch]

Parts:
J18: Conn_01x07_Male; JST_PH_B7B-PH-K_1x07_P2.00mm_Vertical

Connections:
+3V3: J18.7; also elsewhere on the board
DIR: J18.5; also elsewhere on the board
ENC_OUT: J18.6; also elsewhere on the board
GND: J18.1; also elsewhere on the board
I2C_SCL: J18.4; also elsewhere on the board
I2C_SDA: J18.3; also elsewhere on the board
PGO: J18.2; also elsewhere on the board

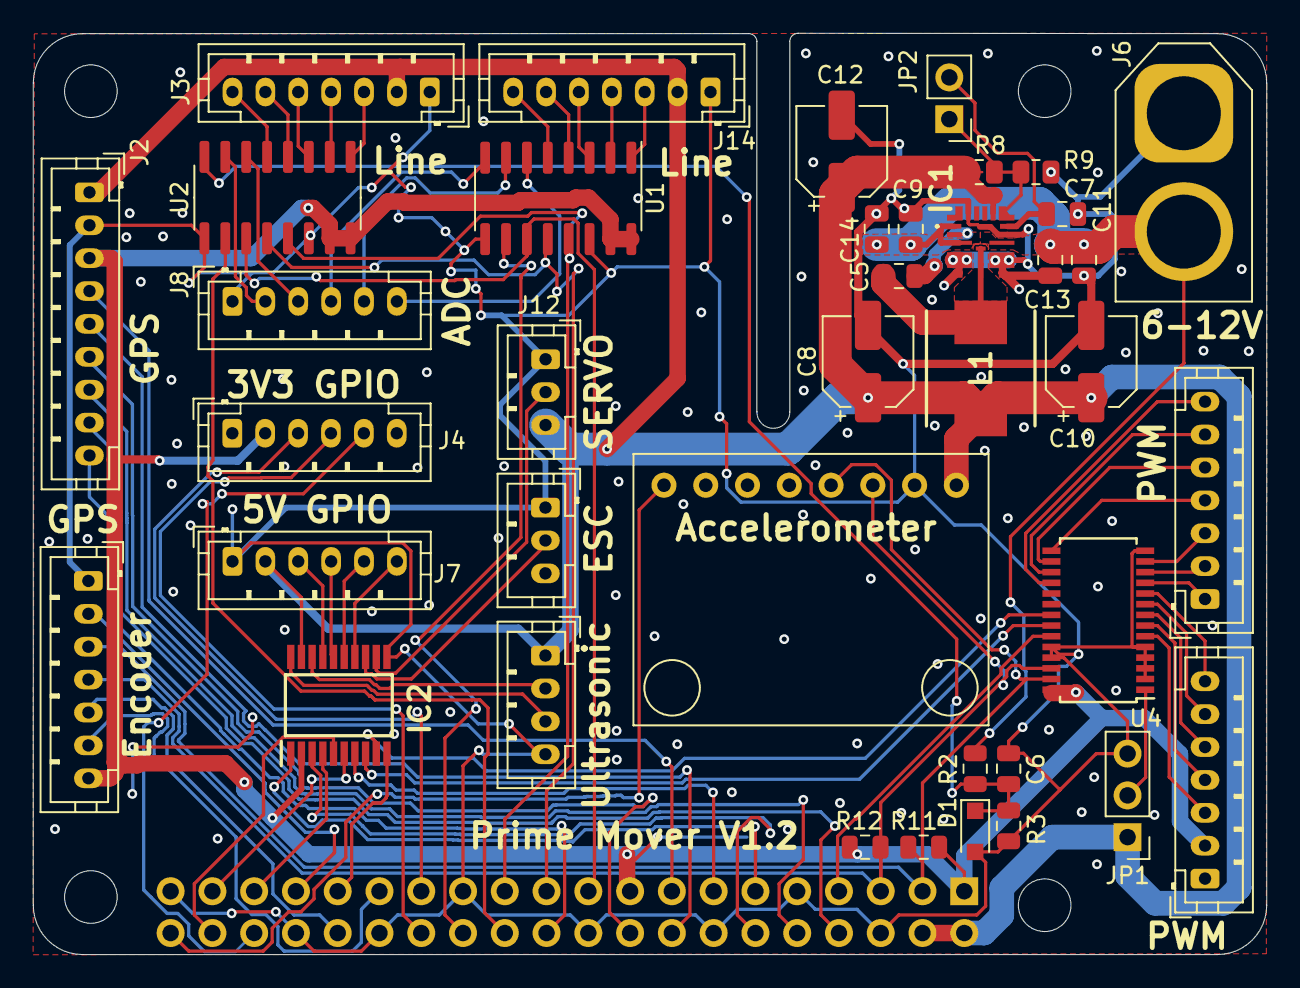
[picture p24: board PiCar Hat.kicad_pcb from above]

Board: 2 copper layers, 75.0 x 56.0 mm, 44 parts (1 on the bottom side), 76 nets.
