dannyandreev/TheLittleRascal-Electrical/FadecandyHatV1.1/FadecandyHatV1.0/FadecandyHatV1.0.kicad_pcb

## KiCad design FadecandyHatV1.1/FadecandyHatV1.0/FadecandyHatV1.0.kicad_pcb (2021-12-15)

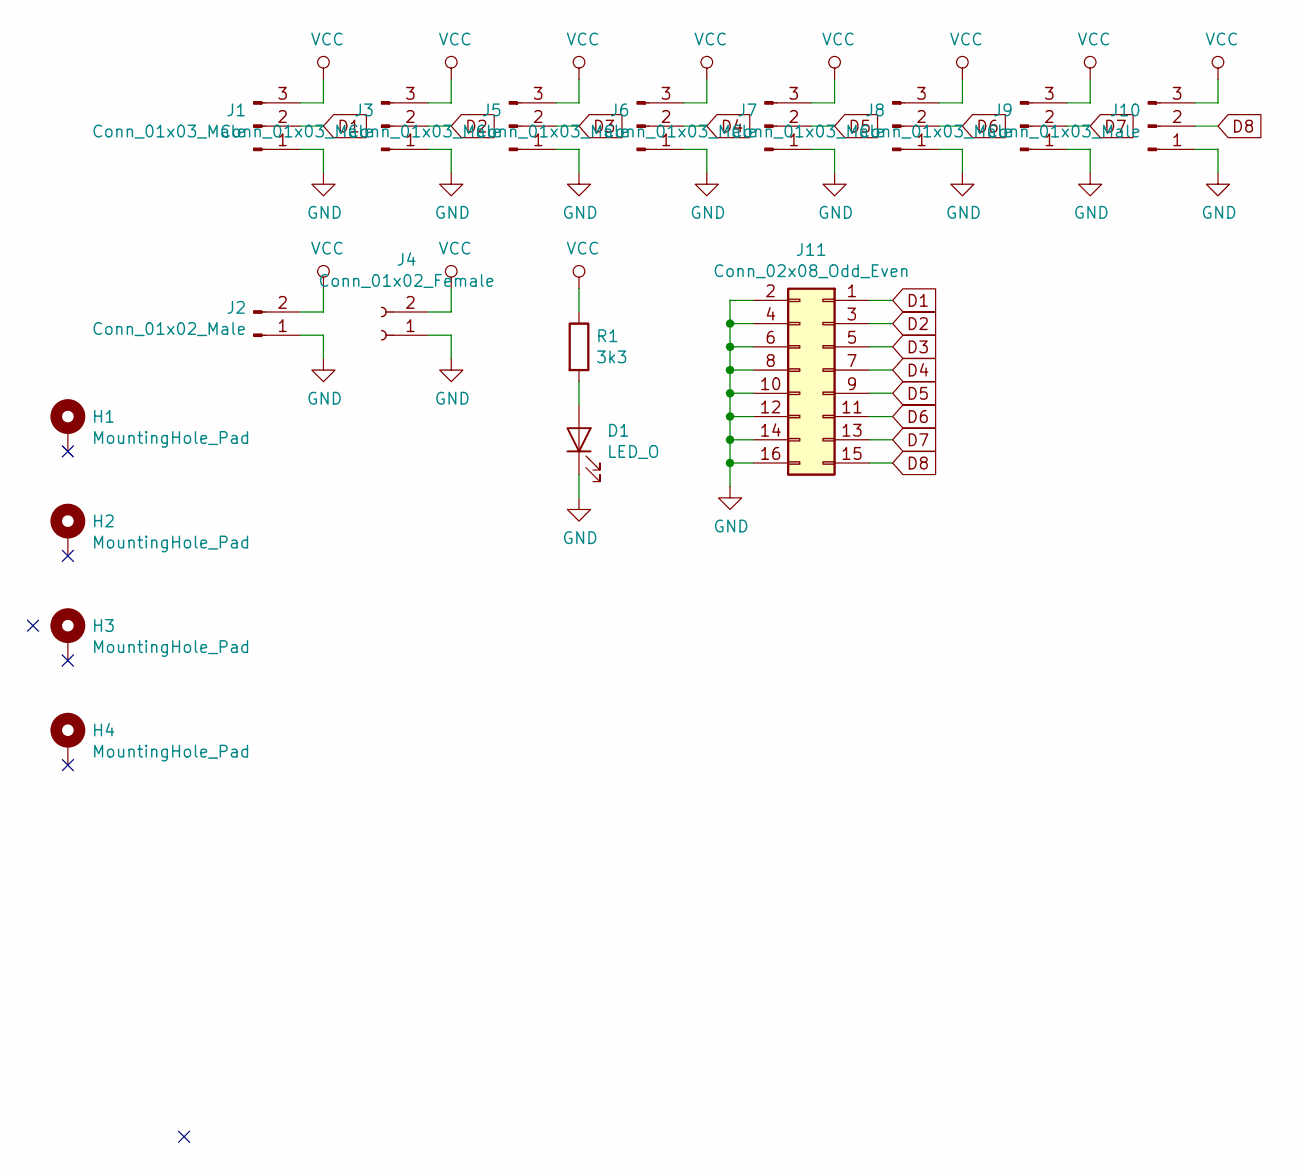
[picture p25: schematic FadecandyHatV1.0.sch]

Parts:
D1: LED_O; LED_0805_2012Metric
H1, H2, H3, H4: MountingHole_Pad; MountingHole_3mm
J1, J3, J5, J6, J7, J8, J9, J10: Conn_01x03_Male; JST_PH_B3B-PH-K_1x03_P2.00mm_Vertical
J2: Conn_01x02_Male; AMASS_XT30U-M_1x02_P5.0mm_Vertical
J4: Conn_01x02_Female; AMASS_XT30U-F_1x02_P5.0mm_Vertical
J11: Conn_02x08_Odd_Even; PinHeader_2x08_P2.54mm_Vertical
R1: 3k3; R_0805_2012Metric

Connections:
D1: J1.2, J11.1
D2: J3.2, J11.3
D3: J5.2, J11.5
D4: J6.2, J11.7
D5: J7.2, J11.9
D6: J8.2, J11.11
D7: J9.2, J11.13
D8: J10.2, J11.15
GND: D1.1 (K), J1.1, J2.1, J3.1, J4.1, J5.1, J6.1, J7.1, J8.1, J9.1, J10.1, J11.2, J11.4, J11.6, J11.8, J11.10, J11.12, J11.14, J11.16
unnamed: D1.2 (A), R1.2
VCC: J1.3, J2.2, J3.3, J4.2, J5.3, J6.3, J7.3, J8.3, J9.3, J10.3, R1.1

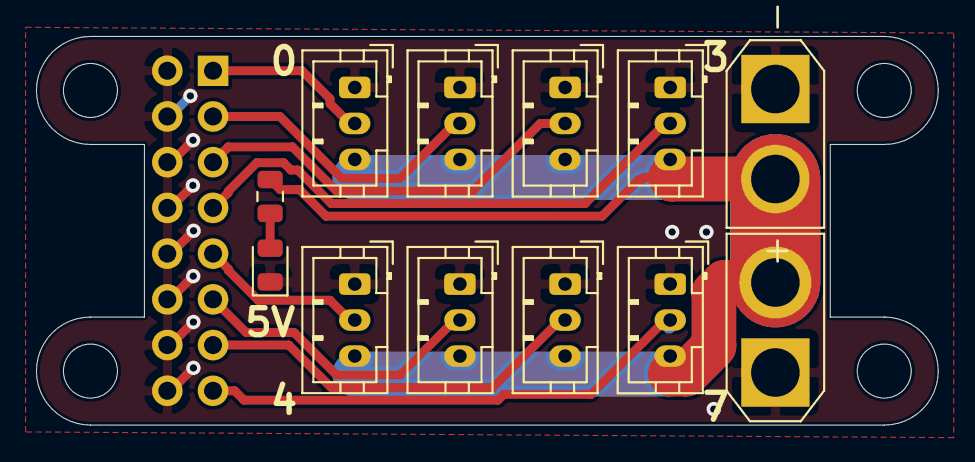
[picture p26: board FadecandyHatV1.0.kicad_pcb from above]

Board: 2 copper layers, 50.1 x 21.6 mm, 17 parts (1 on the bottom side), 11 nets.
