dannyandreev/TheLittleRascal-Electrical/Prime Mover V1.0/RascalHat.kicad_pcb

## KiCad design Prime Mover V1.0/RascalHat.kicad_pcb (2021-11-04, an earlier design)

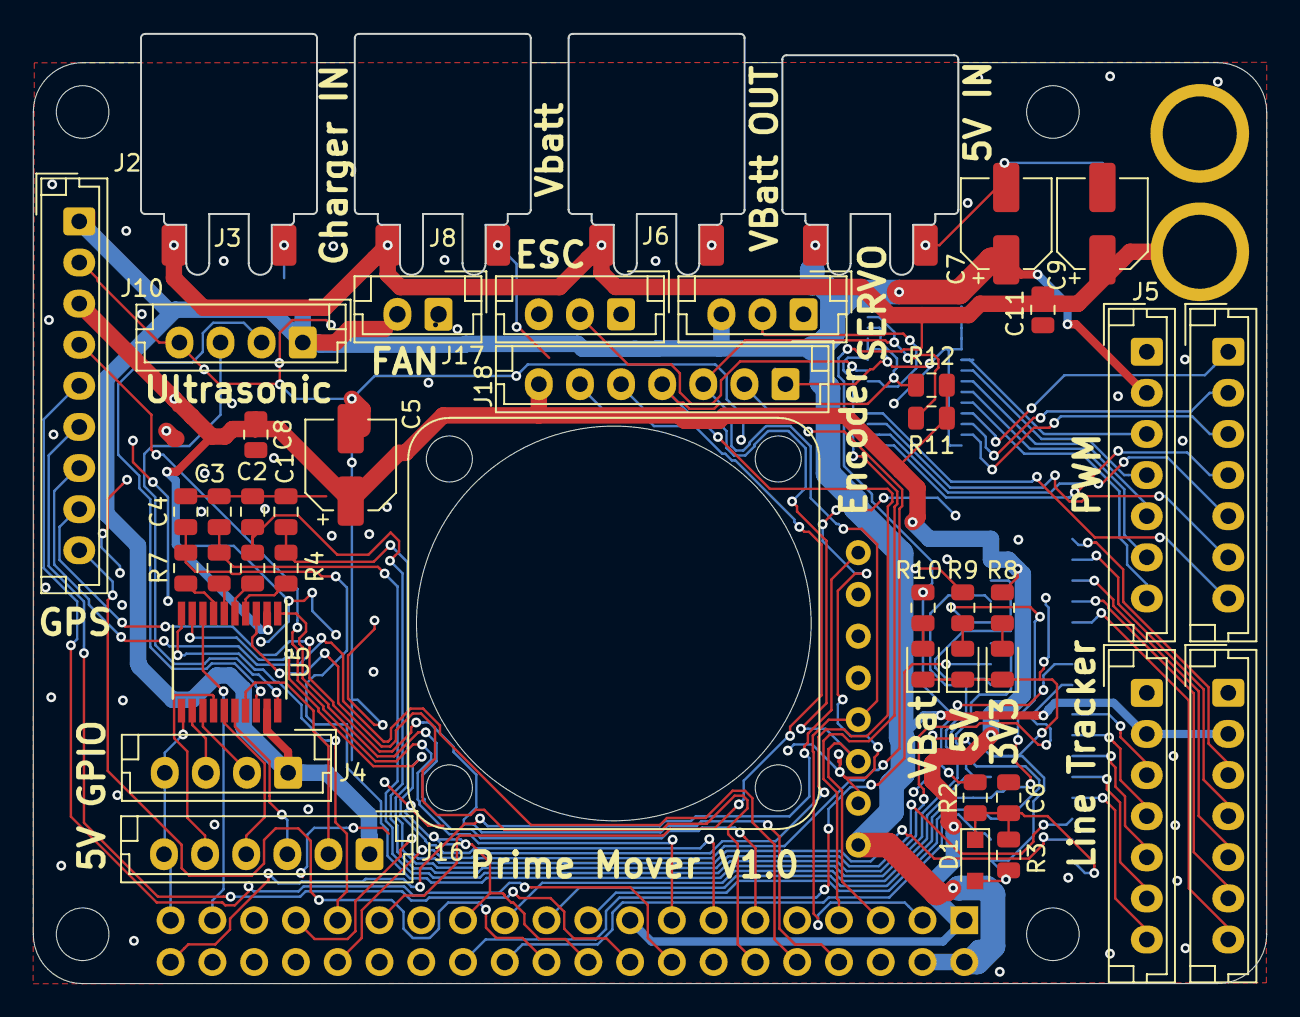
[picture p27: board RascalHat.kicad_pcb from above]

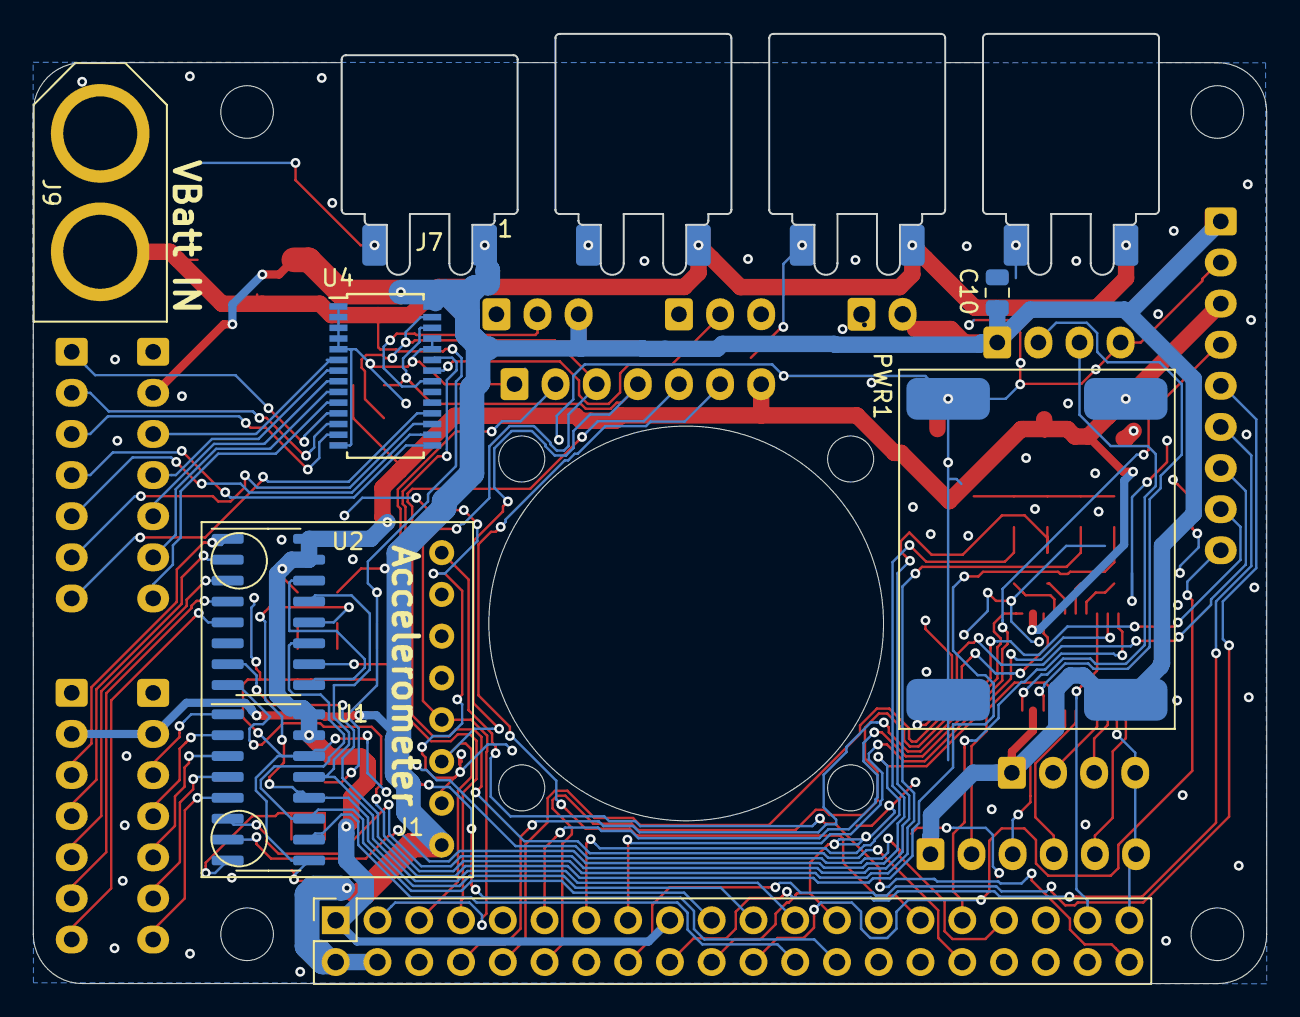
[picture p28: board RascalHat.kicad_pcb from below]

Board: 2 copper layers, 75.0 x 57.8 mm, 55 parts (9 on the bottom side), 71 nets.

Parts:
C1, C2, C3, C4, C6, C8, C10, C11: 0.1uF; C_0805_2012Metric
C5, C7, C9: 27uF 16V; CP_Elec_5x5.3
D1: 3V6; D_SOD-323_HandSoldering
D2, D3, D4: LED; D_0805_2012Metric
FAN1: FAN; 25mm-FAN
H1, H2, H3, H4: MountingHole; MountingHole_3.2mm_M3
J1: Conn_01x08_Male; MPU-6050-Module
J2: Conn_01x09_Male; JST_EH_B9B-EH-A_1x09_P2.50mm_Vertical
J3, J6, J8: Conn_01x02_Male; XT30U-M-Horizontal
J4, J10: Conn_01x04_Male; JST_EH_B4B-EH-A_1x04_P2.50mm_Vertical
J5, J13, J14, J15, J18: Conn_01x07_Male; JST_EH_B7B-EH-A_1x07_P2.50mm_Vertical
J7: Conn_01x02_Female; XT30U-F-Horizontal
J9: Conn_01x02_Male; XT60-M
J11, J12: Conn_01x03_Male; JST_EH_B3B-EH-A_1x03_P2.50mm_Vertical
J16: Conn_01x06_Male; JST_EH_B6B-EH-A_1x06_P2.50mm_Vertical
J17: Conn_01x02_Male; JST_EH_B2B-EH-A_1x02_P2.50mm_Vertical
PWR1: MP1584_3V3Module; MP1584-Jacobs-Parts-Module
R1: Raspberry_Pi_2_3; PinSocket_2x20_P2.54mm_Vertical
R2: 4.7k; R_0805_2012Metric
R3: 1.5k; R_0805_2012Metric
R4, R5, R6, R7: 10k; R_0805_2012Metric
R8: 470; R_0805_2012Metric
R9: 2k2; R_0805_2012Metric
R10: 3k3; R_0805_2012Metric
R11, R12: 4k7; R_0805_2012Metric
U1, U2: MCP3008-I_P; SOIC-16_3.9x9.9mm_P1.27mm
U4: PCA9685PW; TSSOP-28_4.4x9.7mm_P0.65mm
U5: TXB0108PWR; TSSOP-20_4.4x6.5mm_P0.65mm

Connections:
+3V3: C5.1, C8.1, J2.3, J18.7, PWR1.3, R1.1, R1.17, R8.1, R11.1, R12.1, U1.15, U1.16, U2.15, U2.16, U5.2
+5V: C7.1, C10.1, J1.1, J2.1, J4.1, J5.2, J7.1, J10.1, J12.3, J14.2, J15.2, J16.1, J17.2, PWR1.2, R1.2, R1.4, R9.1, U4.28, U5.19
+BATT: C9.1, C11.1, J3.2, J6.2, J8.2, J9.2, R2.1, R10.1
/Level Shift TXB0108/B3: J16.2, U5.17
/Level Shift TXB0108/B4: J16.3, U5.16
/Level Shift TXB0108/B5: J16.4, U5.15
/Level Shift TXB0108/B6: J16.5, U5.14
/MCP3008/ADC0_CH6: C4.1, R7.2, U2.7
/MCP3008/ADC0_CH7: C3.1, R6.2, U2.8
/MCP3008/ADC1_CH5: C2.1, R5.2, U1.6
/MCP3008/ADC1_CH6: C1.1, R4.2, U1.7
/PWM_PCA9685/P0: J5.3, U4.6
/PWM_PCA9685/P1: J5.4, U4.7
/PWM_PCA9685/P2: J5.5, U4.8
/PWM_PCA9685/P3: J5.6, U4.9
/PWM_PCA9685/P4: J5.7, U4.10
/PWM_PCA9685/P5: J13.1, U4.11
/PWM_PCA9685/P6: J13.2, U4.12
/PWM_PCA9685/P7: J13.3, U4.13
/PWM_PCA9685/P8: J13.4, U4.15
/PWM_PCA9685/P9: J13.5, U4.16
/PWM_PCA9685/P10: J13.6, U4.17
/PWM_PCA9685/P11: J13.7, U4.18
A7: R1.37, U5.8
A8: R1.13, U5.9
B7: J4.2, U5.13
B8: J4.3, U5.12
CH1_A: R4.1, U5.4
CH2_A: R5.1, U5.5
CH3_A: R6.1, U5.6
CH4_A: R7.1, U5.7
DIR: J18.5, R1.32
ECHO_3V3: R1.11, U5.1
ECHO_5V: J10.3, U5.20
ENC_OUT: J18.6, R1.29
GND: C1.2, C2.2, C3.2, C4.2, C5.2, C6.2, C7.2, C8.2, C9.2, C10.2, C11.2, D1.2, D2.1, D3.1, D4.1, J1.2, J2.2, J3.1, J4.4, J5.1, J6.1, J7.2, J8.1, J9.1, J10.4, J11.1, J12.1, J14.1, J15.1, J16.6, J17.1, J18.1, PWR1.1, PWR1.4, R1.6, R1.9, R1.14, R1.20, R1.25, R1.30, R1.34, R1.39, R3.2, U1.9, U1.14, U2.9, U2.14, U4.1, U4.2, U4.3, U4.4, U4.5, U4.14, U4.24, U4.25, U5.11
GPIO21: J1.8, R1.40
GPS_DTR: J2.4, R1.15
GPS_PWR: J2.5, R1.16
GPS_RI: J2.6, R1.18
GPS_RST: J2.9, R1.22
GPS_RX: J2.8, R1.8
GPS_TX: J2.7, R1.10
I2C_SCL: J1.3, J18.4, R1.5, R12.2, U4.26
I2C_SDA: J1.4, J18.3, R1.3, R11.2, U4.27
LVL_OE: R1.31, U5.10
unnamed: D2.2, R8.2
unnamed: D3.2, R9.2
unnamed: D4.2, R10.2
unnamed: J14.3, U2.1
unnamed: J14.4, U2.2
unnamed: J14.5, U2.3
unnamed: J14.6, U2.4
unnamed: J14.7, U2.5
unnamed: J15.3, U1.1
unnamed: J15.4, U1.2
unnamed: J15.5, U1.3
unnamed: J15.6, U1.4
unnamed: J15.7, U1.5
PGO: J18.2, R1.33
PWM_ESC: J11.2, U4.22
PWM_Servo: J12.2, U4.21
PWM_~OE: R1.7, U4.23
SPI_CLK: R1.23, U1.13, U2.13
SPI_CS_ADC0: R1.26, U2.10
SPI_CS_ADC1: R1.24, U1.10
SPI_MISO: R1.21, U1.12, U2.12
SPI_MOSI: R1.19, U1.11, U2.11
TRIG_3V3: R1.12, U5.3
TRIG_5V: J10.2, U5.18
VBAT_Read: C6.1, D1.1, R2.2, R3.1, U1.8
