dannyandreev/TheLittleRascal-Electrical/(commit log)

2021-09-21 Add files via upload
    Added schematic files
    [RascalHat.kicad_pcb, RascalHat.sch]
2021-09-21 re-committing schematic to keep file hierarchy
    [RascalHat.kicad_pcb, RascalHat.sch]
2021-10-05 update schematic
    [RascalHat.sch]
2021-10-19 ...tweaking schematic....
    [RascalHat.sch]
2021-10-19 everything except accelerometer done
    [RascalHat.sch]
2021-10-22 using only connector for accelerometer
    [RascalHat.sch]
2021-10-23 fade candy pcb done
    [FadecandyHatV1.0-B_Cu.gbr, FadecandyHatV1.0-B_Mask.gbr, FadecandyHatV1.0-B_Paste.gbr, FadecandyHatV1.0-B_SilkS.gbr, FadecandyHatV1.0-Edge_Cuts.gbr, FadecandyHatV1.0-F_Cu.gbr, FadecandyHatV1.0-F_Mask.gbr, FadecandyHatV1.0-F_Paste.gbr]
2021-10-24 schematic updated
    [AS5600 Magnetic Encoder.sch, Accelerometer MPU6050.sch, FadecandyHatV1.0.kicad_pcb, FadecandyHatV1.0.sch, MCP3008_1.sch, POWER.sch, PWM_PCA9685.sch, RascalHat.sch]
2021-10-25 corruption change
    [RascalHat.sch]
2021-10-31 schematic done, symbol-footprint done, pcb started
    [AS5600 Magnetic Encoder.sch, Accelerometer MPU6050.sch, Level Shift TXB0108.sch, MCP3008_1.sch, POWER.sch, PWM_PCA9685.sch, Radio Receiver.sch, RascalHat.sch]
2021-10-31 schematic updated, all footprints created, pcb layout started
    [Accelerometer MPU6050.sch, Level Shift TXB0108.sch, MCP3008_1.sch, POWER.sch, RascalHat.kicad_pcb, RascalHat.sch]
2021-11-01 schematic capacitors added, pcb done, gerbers generated
    [AS5600 Magnetic Encoder.sch, Accelerometer MPU6050.sch, Level Shift TXB0108.sch, MCP3008_1.sch, POWER.sch, PWM_PCA9685.sch, Radio Receiver.sch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]
2021-11-04 pcb XT60 location adjusted, i2C pullup resistors added
    [FadecandyHatV1.0-B_Cu.gbr, FadecandyHatV1.0-B_Mask.gbr, FadecandyHatV1.0-B_Paste.gbr, FadecandyHatV1.0-B_SilkS.gbr, FadecandyHatV1.0-Edge_Cuts.gbr, FadecandyHatV1.0-F_Cu.gbr, FadecandyHatV1.0-F_Mask.gbr, FadecandyHatV1.0-F_Paste.gbr]
2021-11-15 V1.1 Created, updated connectors on fadecandy and prime mover. changed fan mounting holes
    [AS5600 Magnetic Encoder.sch, Accelerometer MPU6050.sch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]
2021-12-15 V1.1 Manufactured
    [FadecandyHatV1.0.kicad_pcb, POWER.sch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]
2021-12-15 Rascal hat pcb (#10)
    * pcb XT60 location adjusted, i2C pullup resistors added
    * V1.1 Created, updated connectors on fadecandy and prime mover. changed fan mounting holes
    * V1.1 Manufactured
    [AS5600 Magnetic Encoder.sch, Accelerometer MPU6050.sch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]
2022-01-18 Rascal hat pcb (#11)
    * end of work 2021
    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
2022-02-22 Pihat polish (#16)
    * first revision of V1.2 done
    * polished
    [AS5600 Magnetic Encoder.kicad_sch, AS5600 Magnetic Encoder.sch, Accelerometer MPU6050.kicad_sch, Accelerometer MPU6050.sch, Level Shift TXB0108.kicad_sch, Level Shift TXB0108.sch, MCP3008_1.kicad_sch, MCP3008_1.sch]
2022-07-29 Pihat polish (#17)
    * Prime Mover V1.4
    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
    [AS5600 Magnetic Encoder.kicad_sch, AS5600 Magnetic Encoder.sch, Accelerometer MPU6050.kicad_sch, Level Shift TXB0108.kicad_sch, Level Shift TXB0108.sch, MCP3008_1.kicad_sch, MCP3008_1.sch, POWER.kicad_sch]
2022-08-15 Pihat polish (#18)
    * V1.5 done
    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
    [AS5600 Magnetic Encoder.kicad_sch, AS5600 Magnetic Encoder.sch, Accelerometer MPU6050.kicad_sch, Level Shift TXB0108.kicad_sch, Level Shift TXB0108.sch, MCP3008_1.kicad_sch, MCP3008_1.sch, POWER.kicad_sch]
2022-11-23 V1.6 (#19)
    * PCBA quoted - generated BOM & POS
    * BOM file updated
    [AS5600 Magnetic Encoder.sch, Level Shift TXB0108.sch, MCP3008_1.kicad_sch, MCP3008_1.sch, POWER.kicad_sch, POWER.sch, PWM_PCA9685.sch, Prime Mover V1.6 BOM.ods]
